mogillc/nico/README.md

# nico
The nico hexapod hardware and software files.

http://svn.mogi.io:8080/api/api/

To purchase 3D printed models please visit our shapeways store:
https://www.shapeways.com/shops/mogi
