mogillc/nico/edisonLibmogiPackage/examples/openGL/Objects/brickWall/diffuse.png

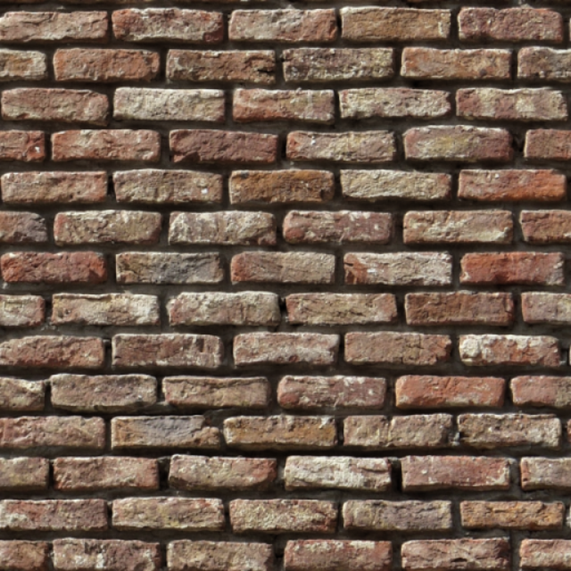
edisonLibmogiPackage/examples/openGL/Objects/brickWall/diffuse.png
