mogillc/nico/edisonLibmogiPackage/examples/openGL/Objects/brickWall/displacement.png

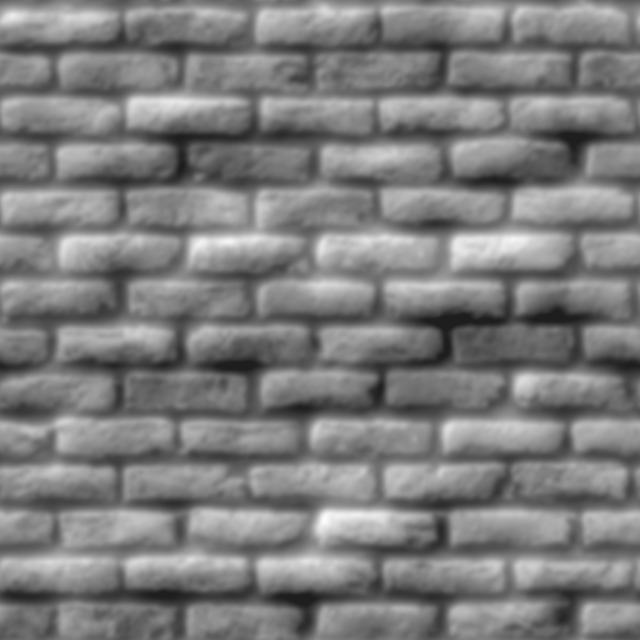
edisonLibmogiPackage/examples/openGL/Objects/brickWall/displacement.png
