mogillc/nico/edisonLibmogiPackage/examples/openGL/Objects/brickWall/normals.png

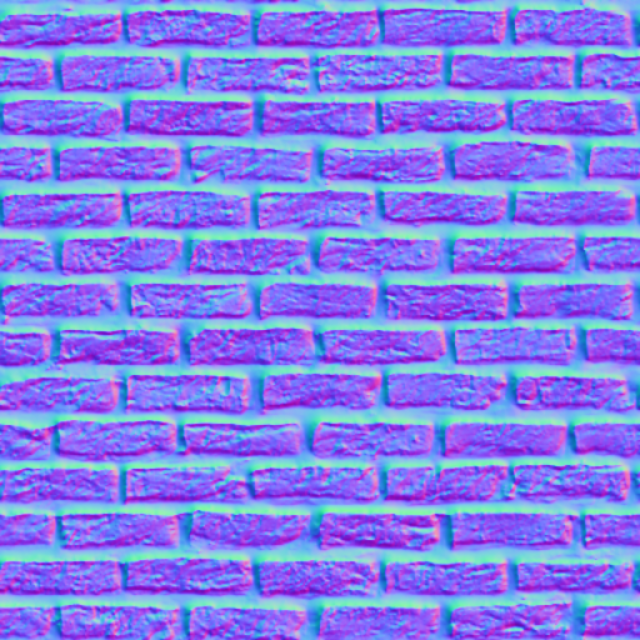
edisonLibmogiPackage/examples/openGL/Objects/brickWall/normals.png
