mogillc/nico/edisonLibmogiPackage/examples/openGL/Objects/brickWall/occlusion.png

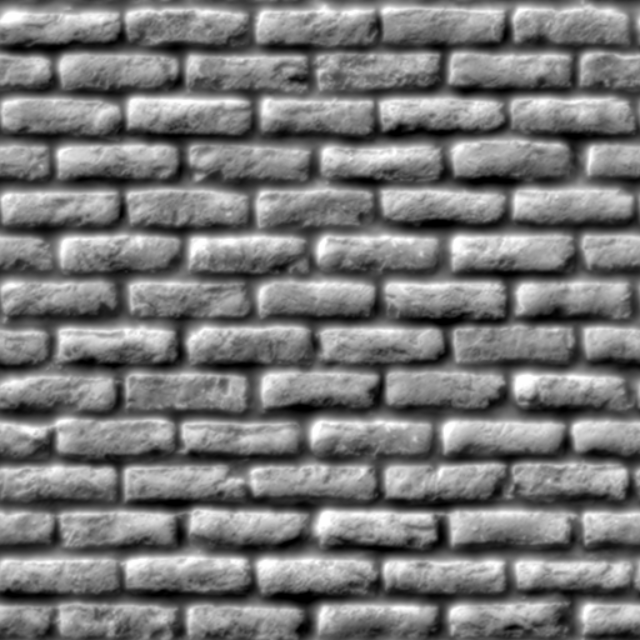
edisonLibmogiPackage/examples/openGL/Objects/brickWall/occlusion.png
