mogillc/nico/edisonLibmogiPackage/examples/openGL/Objects/brickWall/specularity.png

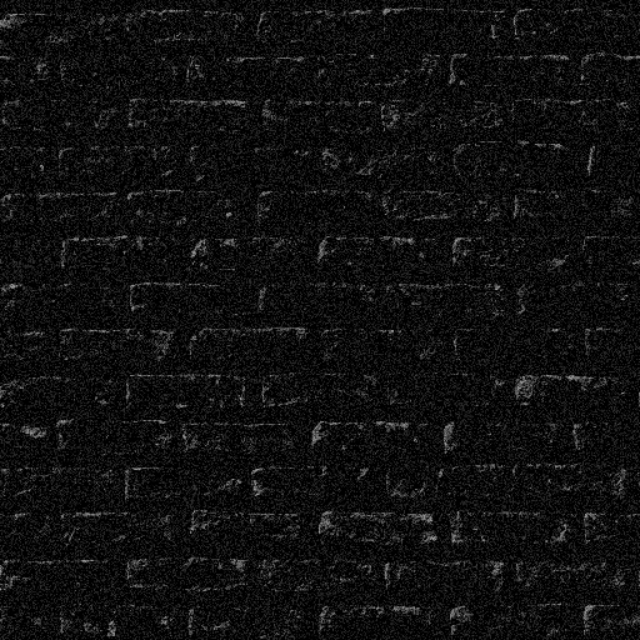
edisonLibmogiPackage/examples/openGL/Objects/brickWall/specularity.png
