mogillc/nico/edisonLibmogiPackage/examples/openGL/Objects/diffuse.png

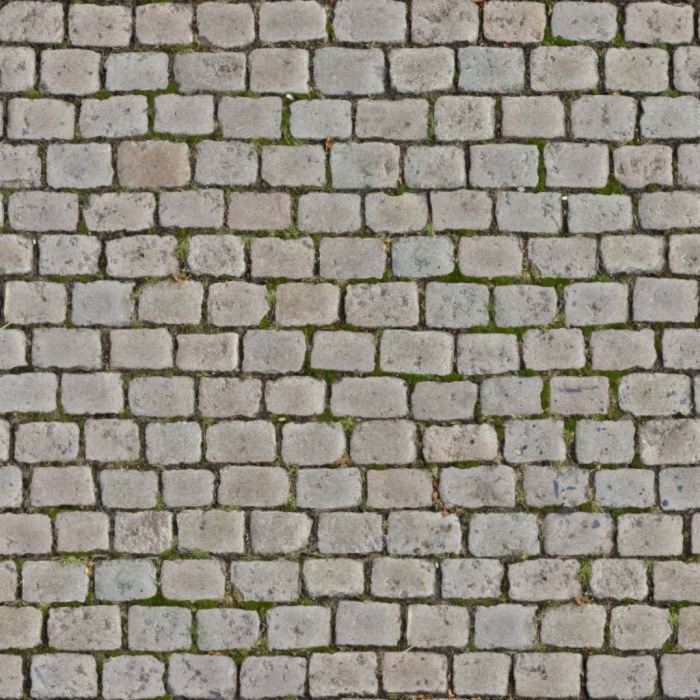
edisonLibmogiPackage/examples/openGL/Objects/diffuse.png
