mogillc/nico/edisonLibmogiPackage/examples/openGL/Objects/displacement.png

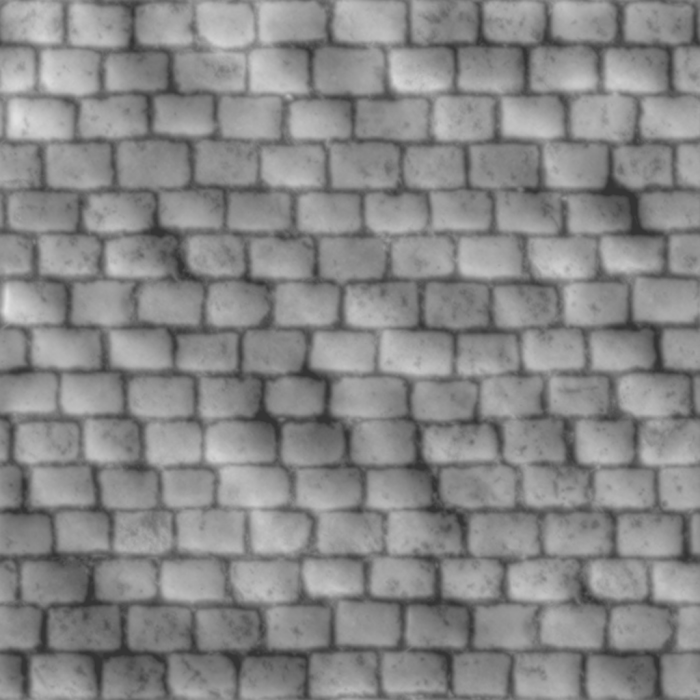
edisonLibmogiPackage/examples/openGL/Objects/displacement.png
