mogillc/nico/edisonLibmogiPackage/examples/openGL/Objects/normals.png

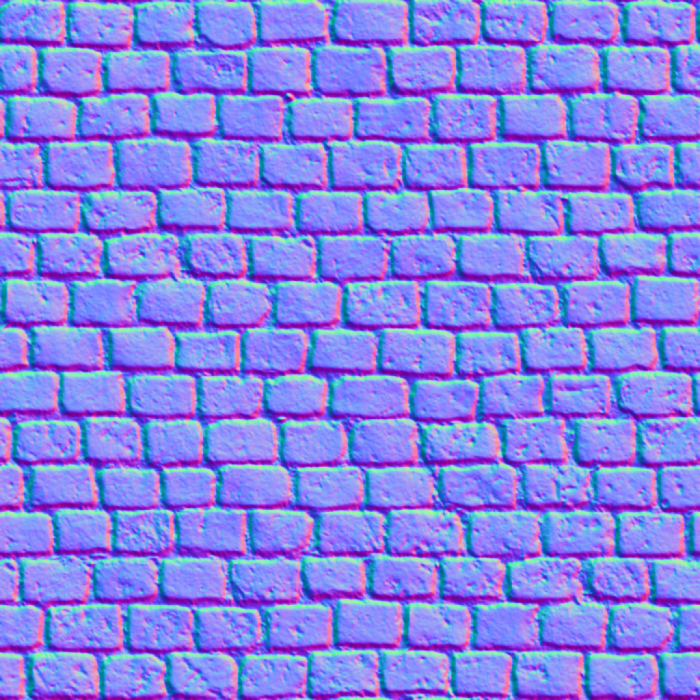
edisonLibmogiPackage/examples/openGL/Objects/normals.png
