mogillc/nico/edisonLibmogiPackage/examples/openGL/Objects/occlusion.png

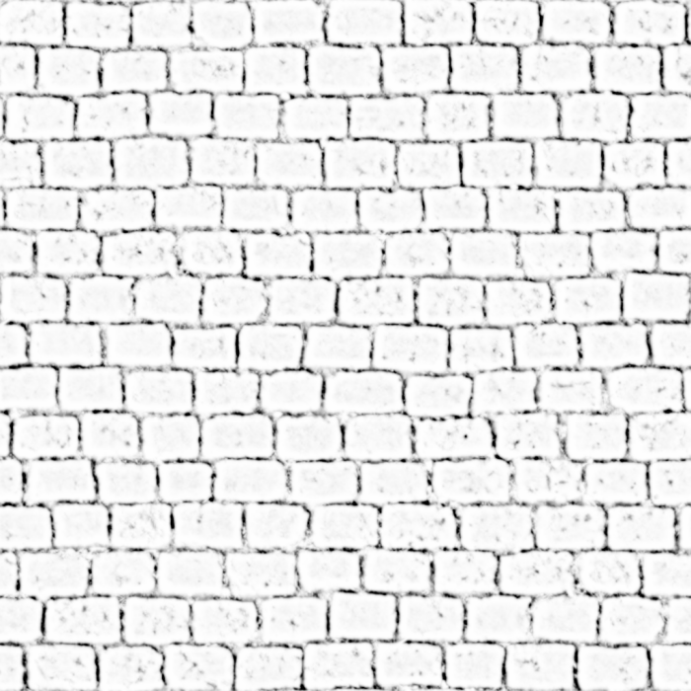
edisonLibmogiPackage/examples/openGL/Objects/occlusion.png
