mogillc/nico/edisonLibmogiPackage/examples/openGL/Objects/specularity.png

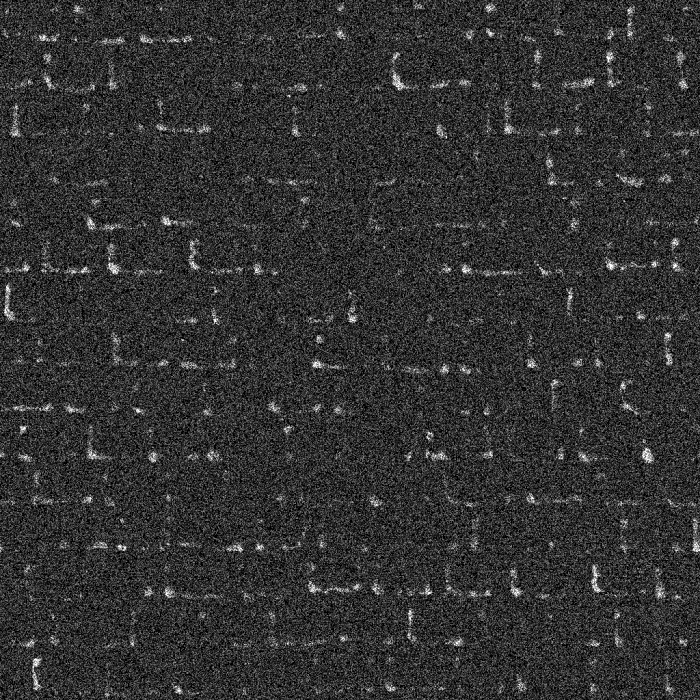
edisonLibmogiPackage/examples/openGL/Objects/specularity.png
