mogillc/nico/edisonLibmogiPackage/examples/openGL/Pics/brickWall/normals.png

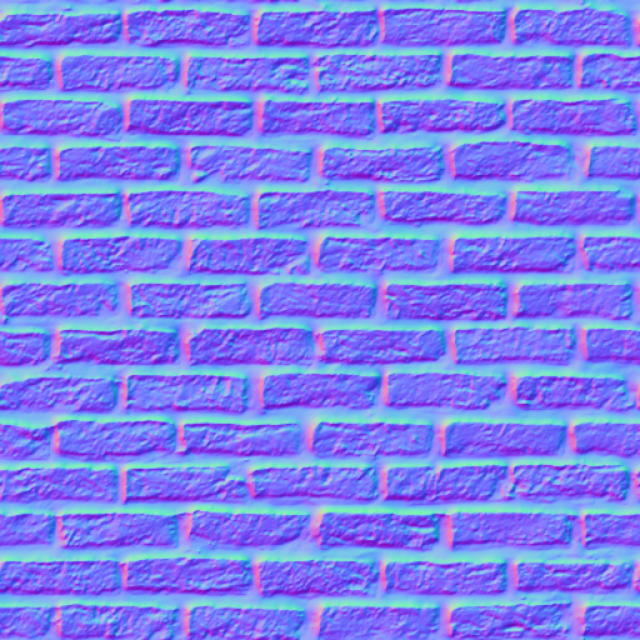
edisonLibmogiPackage/examples/openGL/Pics/brickWall/normals.png
