mogillc/nico/edisonLibmogiPackage/examples/openGL/Pics/Default-568h.png

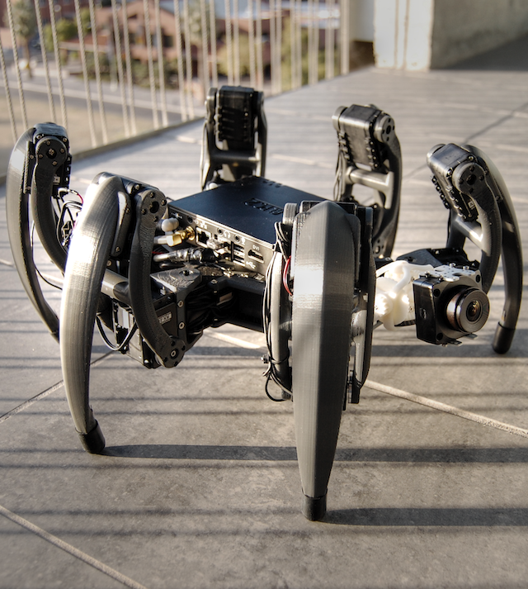
edisonLibmogiPackage/examples/openGL/Pics/Default-568h.png
