mogillc/nico/edisonLibmogiPackage/examples/openGL/Pics/paverStones/normals.png

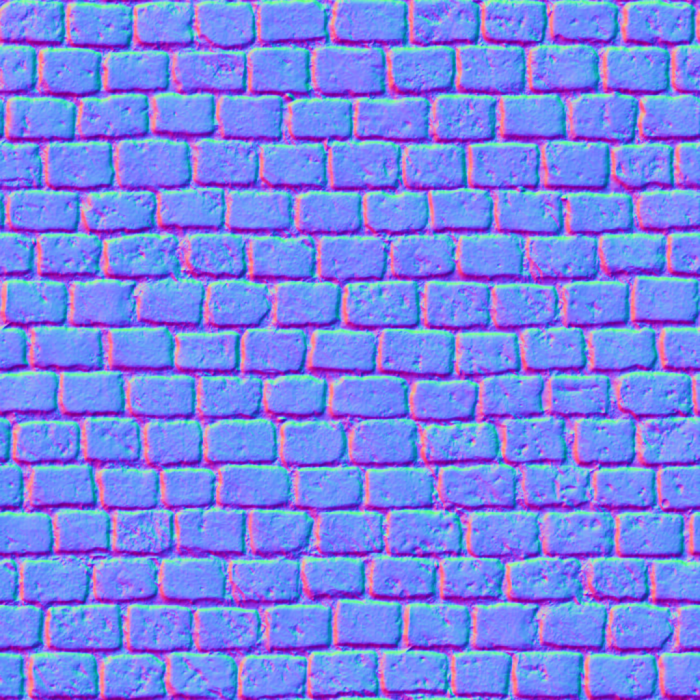
edisonLibmogiPackage/examples/openGL/Pics/paverStones/normals.png
