mogillc/nico/edisonLibmogiPackage/examples/openGL/Pics/paverStones/specularity.png

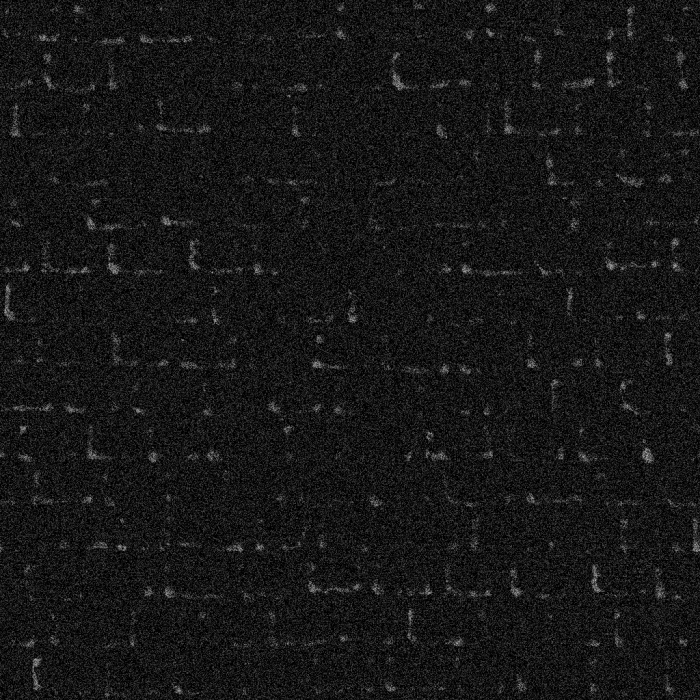
edisonLibmogiPackage/examples/openGL/Pics/paverStones/specularity.png
