mogillc/nico/edisonLibmogiPackage/examples/openGL/Pics/road1/diffuse.png

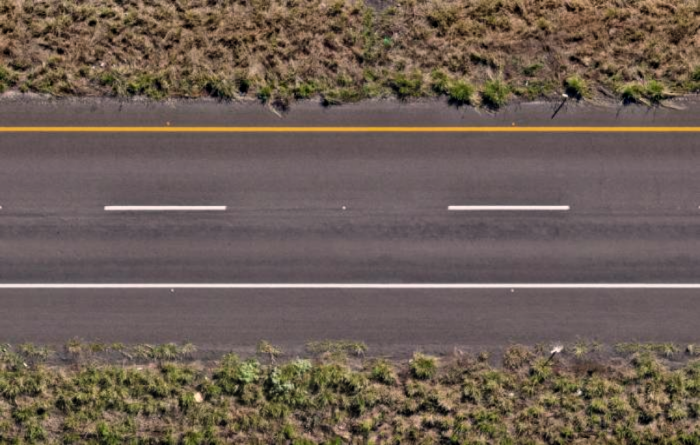
edisonLibmogiPackage/examples/openGL/Pics/road1/diffuse.png
