mogillc/nico/edisonLibmogiPackage/examples/openGL/Pics/road1/displacement.png

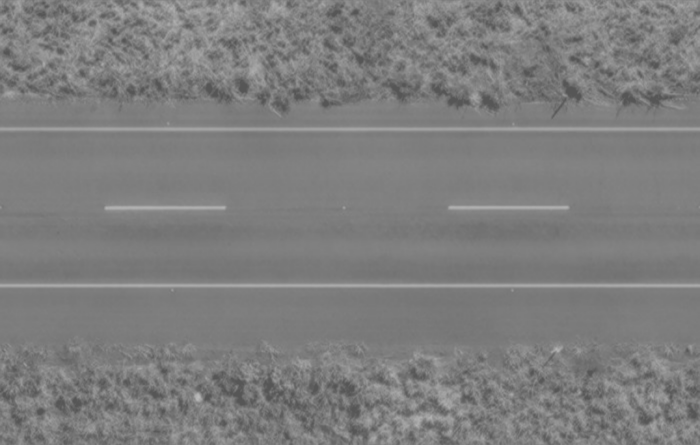
edisonLibmogiPackage/examples/openGL/Pics/road1/displacement.png
