mogillc/nico/edisonLibmogiPackage/examples/openGL/Pics/road1/normals.png

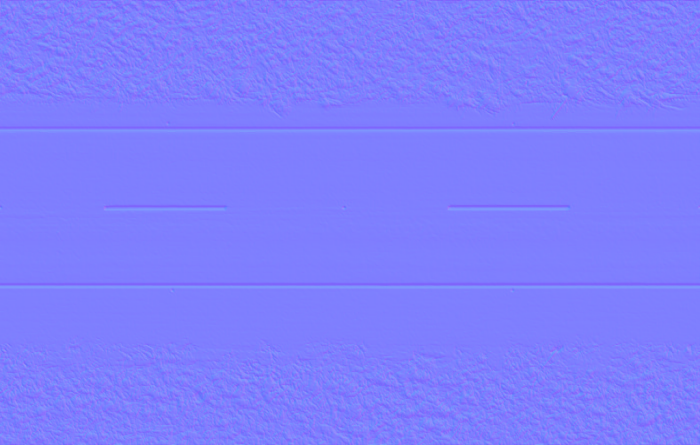
edisonLibmogiPackage/examples/openGL/Pics/road1/normals.png
