mogillc/nico/edisonLibmogiPackage/examples/openGL/Pics/road1/occlusion.png

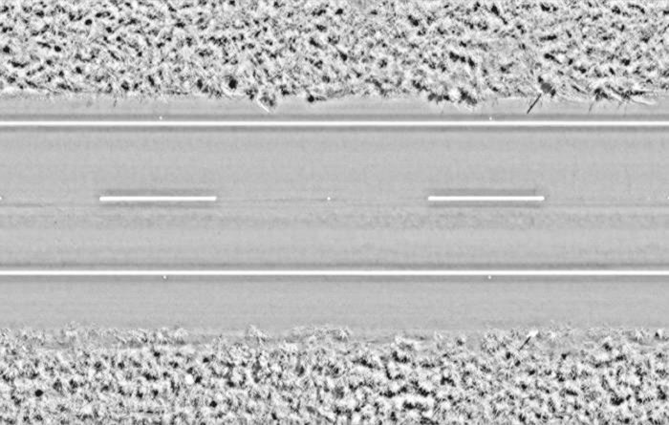
edisonLibmogiPackage/examples/openGL/Pics/road1/occlusion.png
