mogillc/nico/edisonLibmogiPackage/examples/openGL/Pics/road1/specularity.png

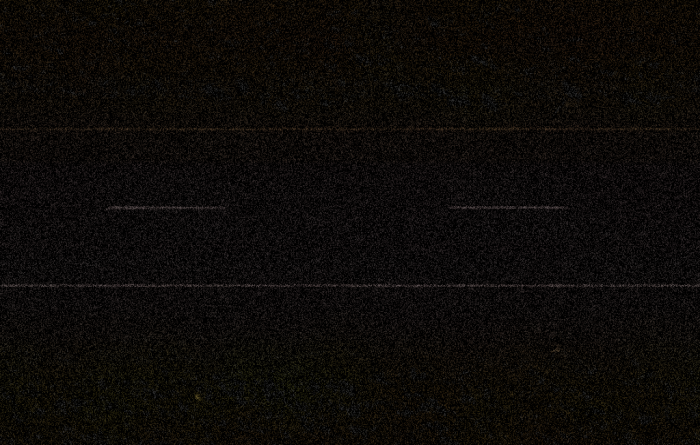
edisonLibmogiPackage/examples/openGL/Pics/road1/specularity.png
