mogillc/nico/edisonLibmogiPackage/examples/openGL/Pics/road2/diffuse.png

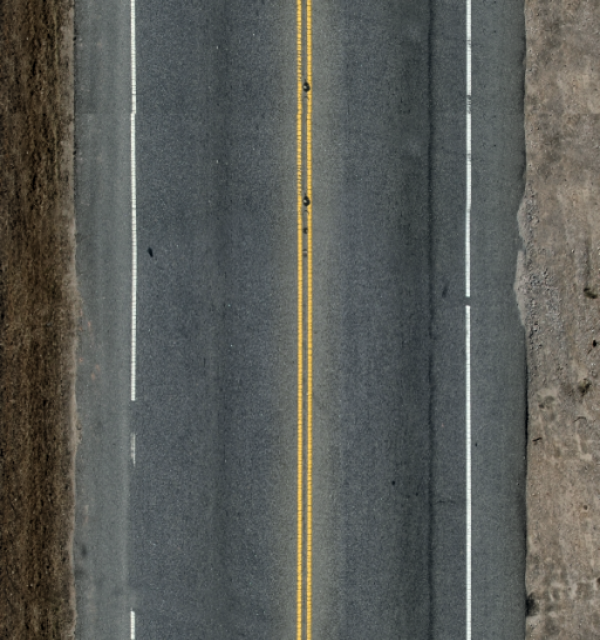
edisonLibmogiPackage/examples/openGL/Pics/road2/diffuse.png
