mogillc/nico/edisonLibmogiPackage/examples/openGL/Pics/road2/displacement.png

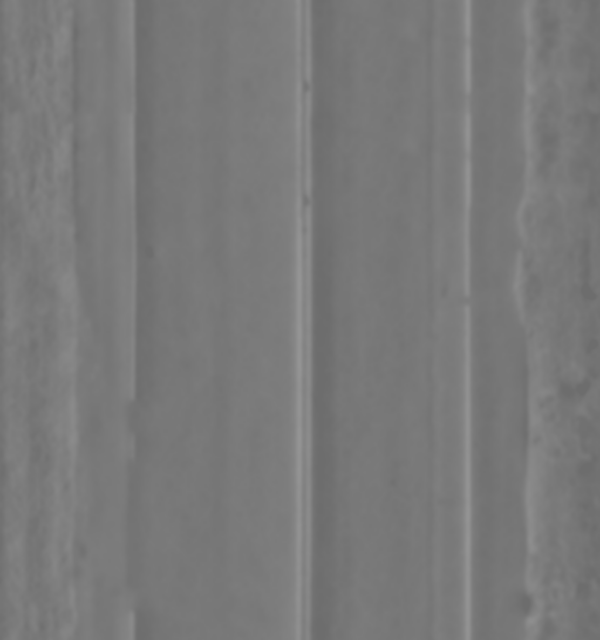
edisonLibmogiPackage/examples/openGL/Pics/road2/displacement.png
