mogillc/nico/edisonLibmogiPackage/examples/openGL/Pics/road2/normals.png

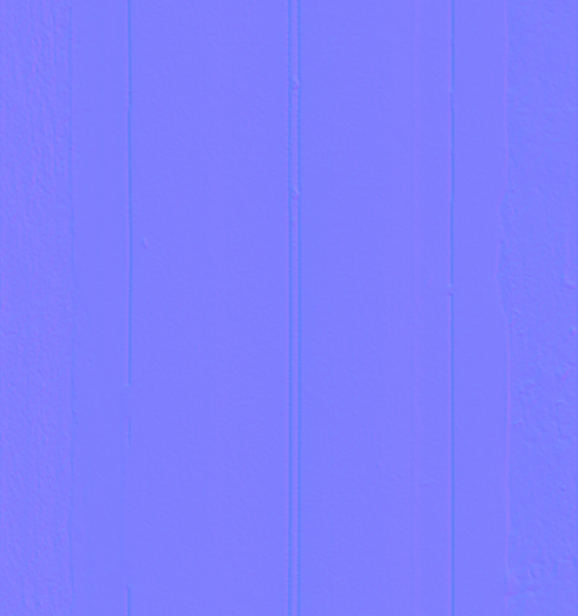
edisonLibmogiPackage/examples/openGL/Pics/road2/normals.png
