mogillc/nico/edisonLibmogiPackage/examples/openGL/Pics/road2/occlusion.png

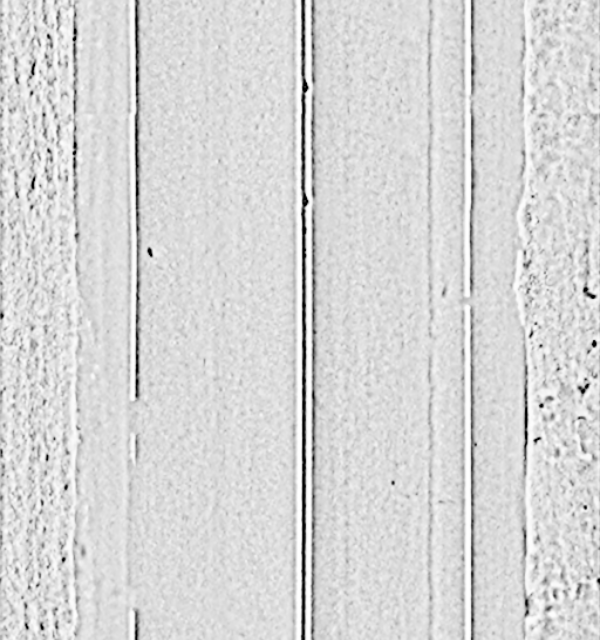
edisonLibmogiPackage/examples/openGL/Pics/road2/occlusion.png
