mogillc/nico/edisonLibmogiPackage/examples/openGL/Pics/road2/specularity.png

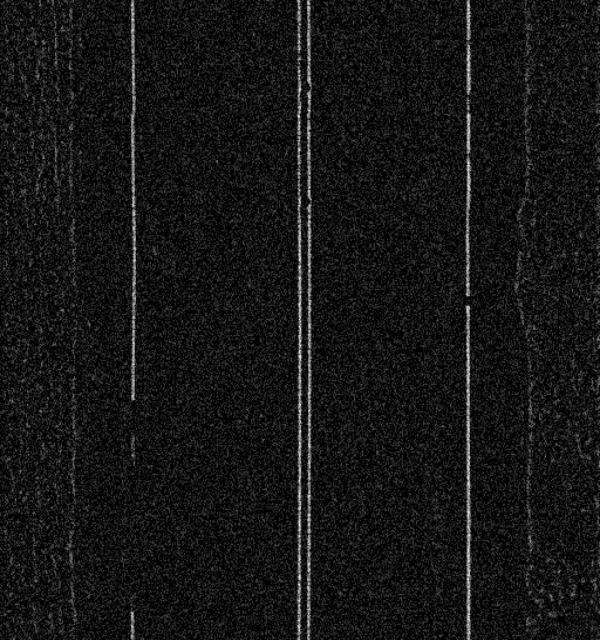
edisonLibmogiPackage/examples/openGL/Pics/road2/specularity.png
