mogillc/nico/edisonLibmogiPackage/examples/openGL/shaderTesting/testTexture/specularity.png

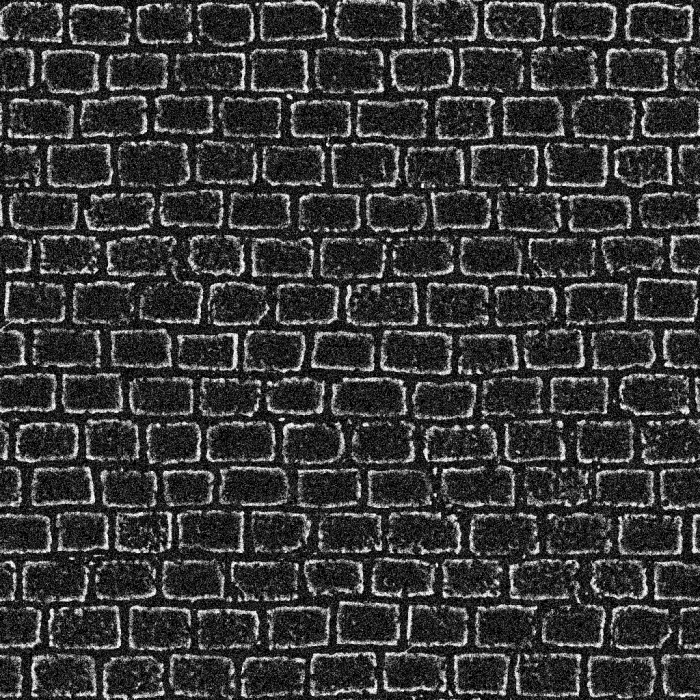
edisonLibmogiPackage/examples/openGL/shaderTesting/testTexture/specularity.png
