mogillc/nico/edisonLibmogiPackage/libmogi/doc/images/app.png

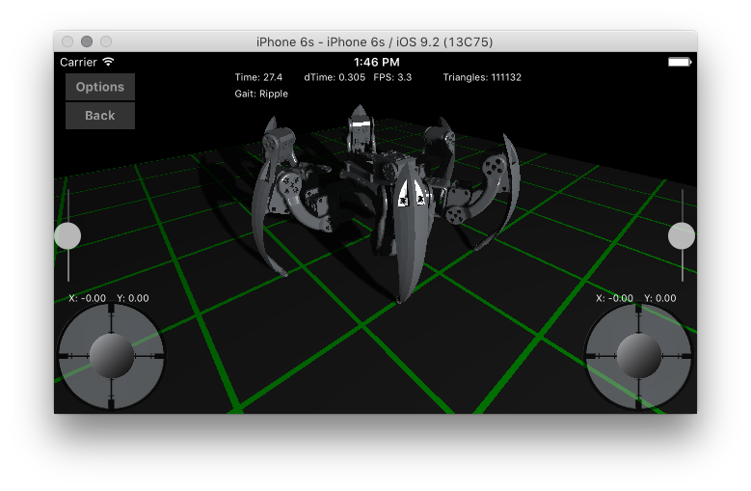
edisonLibmogiPackage/libmogi/doc/images/app.png
