mogillc/nico/edisonLibmogiPackage/libmogi/doc/images/appOptions.png

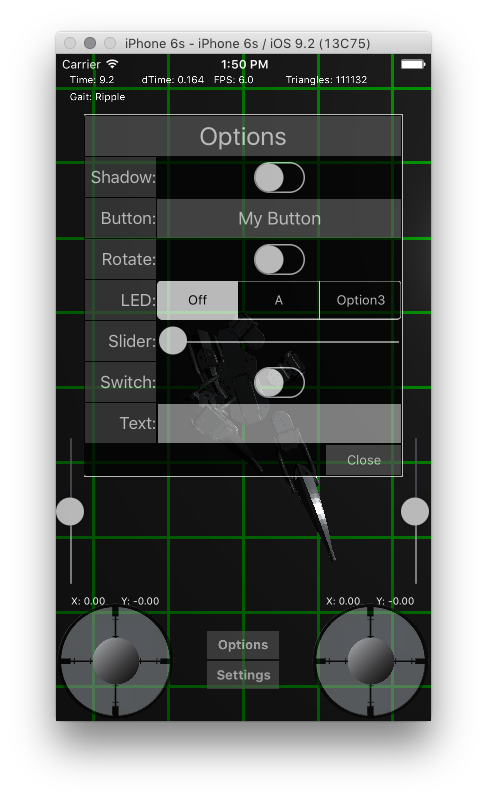
edisonLibmogiPackage/libmogi/doc/images/appOptions.png
