mogillc/nico/edisonLibmogiPackage/libmogi/doc/images/balanceGestures.jpg

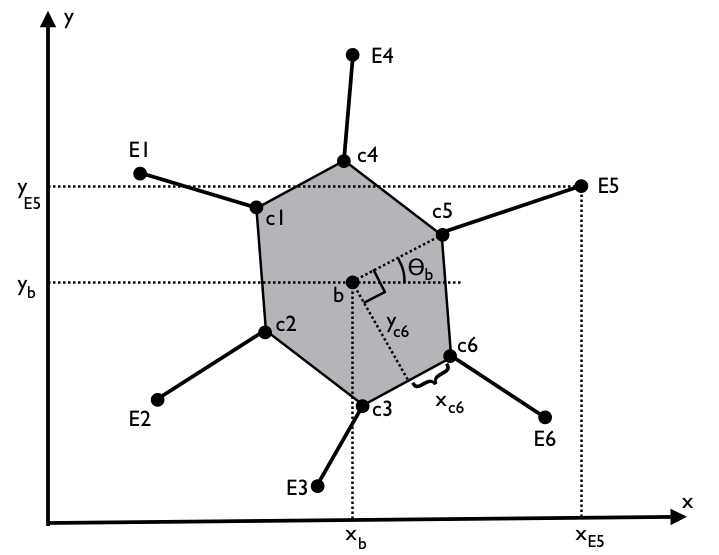
edisonLibmogiPackage/libmogi/doc/images/balanceGestures.jpg
