mogillc/nico/edisonLibmogiPackage/libmogi/doc/images/footTrajectory.jpg

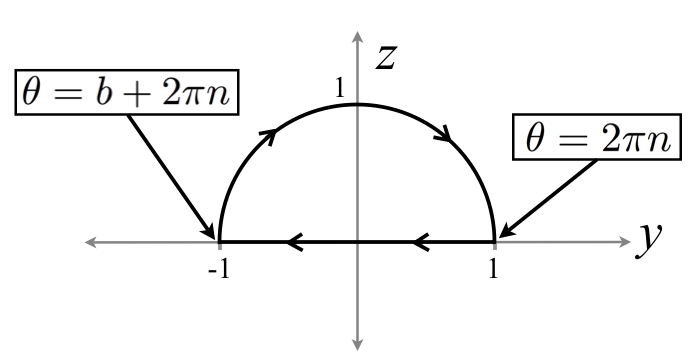
edisonLibmogiPackage/libmogi/doc/images/footTrajectory.jpg
