mogillc/nico/edisonLibmogiPackage/libmogi/doc/images/gaitSequences.jpg

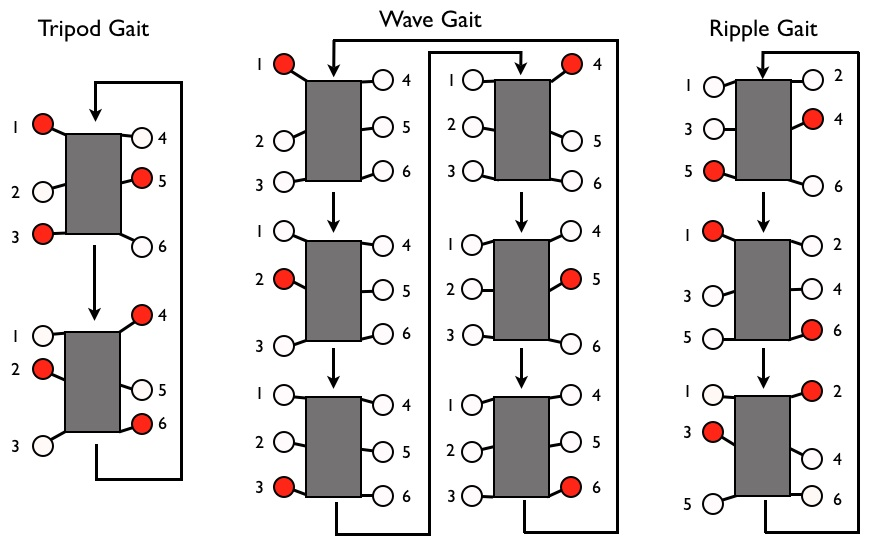
edisonLibmogiPackage/libmogi/doc/images/gaitSequences.jpg
