mogillc/nico/edisonLibmogiPackage/libmogi/doc/images/HexapodState.png

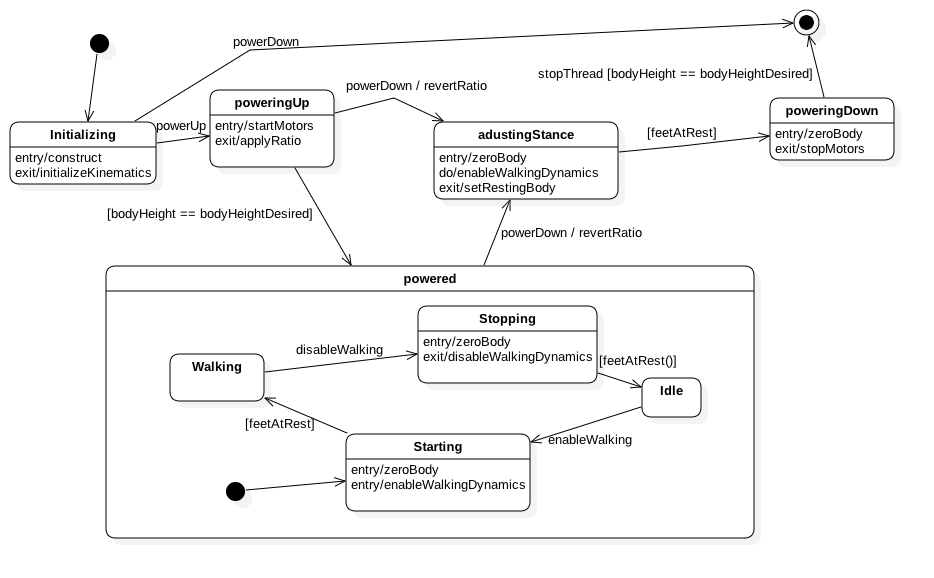
edisonLibmogiPackage/libmogi/doc/images/HexapodState.png
