mogillc/nico/edisonLibmogiPackage/libmogi/doc/images/legKinematics.jpg

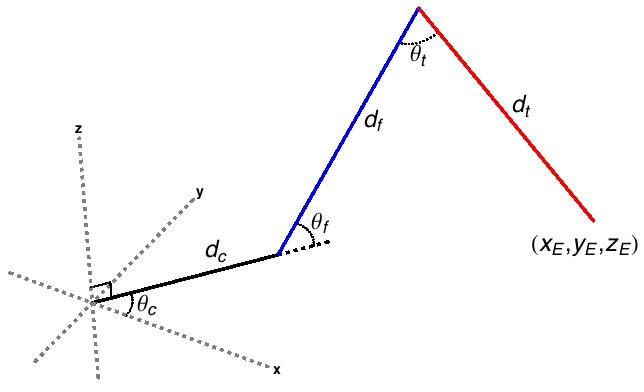
edisonLibmogiPackage/libmogi/doc/images/legKinematics.jpg
