mogillc/nico/edisonLibmogiPackage/libmogi/doc/images/walkingDynamics.jpg

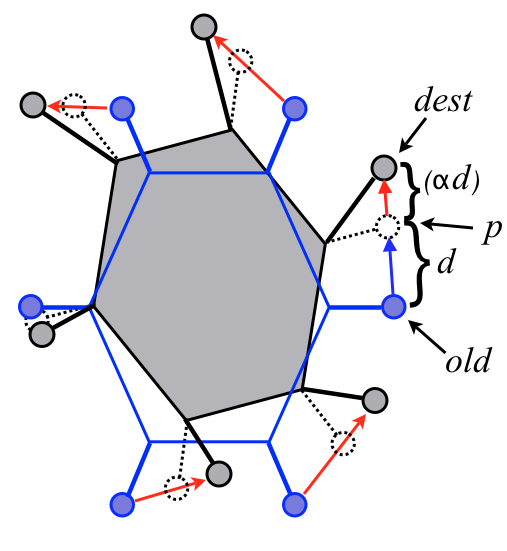
edisonLibmogiPackage/libmogi/doc/images/walkingDynamics.jpg
