mogillc/nico/hardware/pcb/xbee/schematic.png

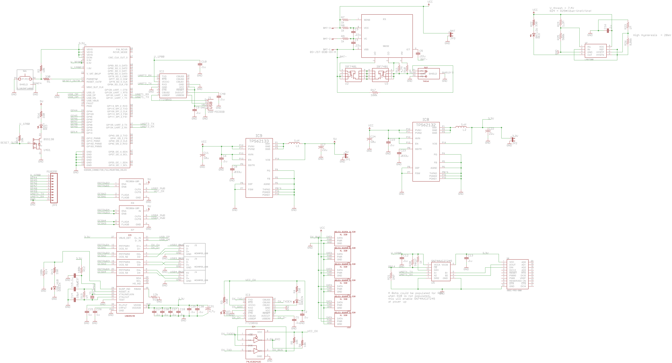
hardware/pcb/xbee/schematic.png
