mogillc/nico/hardware/pcb/BOM.xlsx

 |  |  | Nico BOM
 |  |  |  | Number of hexapods: | 3
description |  | search term/model | Link | Board ID | Qty per hex | Qty total
CAP CER 0.1UF 10V 10% X5R 0402 | LMK105BJ104KV-F | 587-1227-1-ND | http://www.digikey.com/product-detail/en/LMK105BJ104KV-F/587-1227-1-ND/931004 | C1, C2, C6, C9, C10, C17, C18, C19, C20, C25, C27, C37, C38, C48 | 14 | 42
CAP CER 0.033UF 10V 10% X5R 0402 | GRM155R61A333KA01D | 490-5411-1-ND | http://www.digikey.com/product-detail/en/GRM155R61A333KA01D/490-5411-1-ND/2175218 | C8, C23 | 2 | 6
CAP CER 0.22UF 16V 10% X5R 0402 | EMK105BJ224KV-F | 587-1452-1-ND | http://www.digikey.com/product-detail/en/EMK105BJ224KV-F/587-1452-1-ND/1004083 | C3, C4, C5 | 3 | 9
CAP CER 22UF 10V 20% X5R 0603 | C1608X5R1A226M080AC | 445-9077-1-ND | http://www.digikey.com/product-detail/en/C1608X5R1A226M080AC/445-9077-1-ND/3661620 | C7, C22 | 2 | 6
CAP CER 1UF 6.3V 10% X5R 0402 | GRM155R60J105KE19D | 490-1320-1-ND | http://www.digikey.com/product-detail/en/GRM155R60J105KE19D/490-1320-1-ND/587919 | C21, C26 | 2 | 6
CAP CER 10UF 16V 10% X5R 0805 | GRM21BR61C106KE15L | 490-3886-1-ND | http://www.digikey.com/product-detail/en/GRM21BR61C106KE15L/490-3886-1-ND/965928 | C11, C24 | 2 | 6
CAP CER 4.7UF 6.3V 20% X5R 0603 | GRM188R60J475ME19D | 490-5421-1-ND | http://www.digikey.com/product-detail/en/GRM188R60J475ME19D/490-5421-1-ND/2175228 | C31 | 1 | 3
CAP CER 18PF 50V 5% NP0 0402 | CL05C180JB5NNNC | 1276-1140-1-ND | http://www.digikey.com/product-detail/en/CL05C180JB5NNNC/1276-1140-1-ND/3889226 | C14, C15 | 2 | 6
LED RED ORANGE CLEAR 0603 SMD | LTST-C190EKT | 160-1182-1-ND | http://www.digikey.com/product-detail/en/LTST-C190EKT/160-1182-1-ND/269254 | DRX | 1 | 3
LED GREEN CLEAR 0603 SMD | LTST-C190GKT | 160-1183-1-ND | http://www.digikey.com/product-detail/en/LTST-C190GKT/160-1183-1-ND/269255 | DTX, USB_HUB, BOOT | 3 | 9
FIXED IND 1UH 3.1A 35 MOHM SMD | 252012CDMCDS-1R0MC | 308-2342-1-ND | http://www.digikey.com/product-detail/en/252012CDMCDS-1R0MC/308-2342-1-ND/4386567 | L1, L2 | 2 | 6
RES SMD 330 OHM 1% 1/10W 0402 | ERJ-2RKF3300X | P330LCT-ND | http://www.digikey.com/product-detail/en/ERJ-2RKF3300X/P330LCT-ND/1746671 | R1, R3, R4, R13, R16 | 5 | 15
RES SMD 10K OHM 1% 1/10W 0402 | ERJ-2RKF1002X | P10.0KLCT-ND | http://www.digikey.com/product-detail/en/ERJ-2RKF1002X/P10.0KLCT-ND/194119 | R2, R5, R6, R15 | 4 | 12
RES SMD 1K OHM 1% 1/10W 0402 | ERJ-2RKF1001X | P1.00KLCT-ND | http://www.digikey.com/product-detail/en/ERJ-2RKF1001X/P1.00KLCT-ND/97341 | R7, R8, R9, R10 | 4 | 12
RES SMD 4.7M OHM 1% 1/16W 0402 | CRCW04024M70FKED | 541-4.70MLCT-ND | http://www.digikey.com/product-detail/en/CRCW04024M70FKED/541-4.70MLCT-ND/1183541 | R11 | 1 | 3
RES SMD 1M OHM 1% 1/10W 0402 | ERJ-2RKF1004X | P1.00MLCT-ND | http://www.digikey.com/product-detail/en/ERJ-2RKF1004X/P1.00MLCT-ND/79804 | R19 | 1 | 3
RES SMD 12K OHM 1% 1/10W 0402 | ERJ-2RKF1202X | P12.0KLCT-ND | http://www.digikey.com/product-detail/en/ERJ-2RKF1202X/P12.0KLCT-ND/1746638 | R18 | 1 | 3
RES SMD 100K OHM 1% 1/10W 0402 | ERJ-2RKF1003X | P100KLCT-ND | http://www.digikey.com/product-detail/en/ERJ-2RKF1003X/P100KLCT-ND/194127 | R12, R14, R17 | 3 | 9
CRYSTAL 24.0MHZ 18PF SMD | 405I35D24M00000 | CTX1198CT-ND | http://www.digikey.com/product-detail/en/405I35D24M00000/CTX1198CT-ND/4308775 | Y1 | 1 | 3
CONN RCPT 0.4MM SMD 70POS SHLD (for edison, 3mm) | DF40GB(3.0)-70DS-0.4V(51) | DF40GB(3.0)-70DS-0.4V(51)-ND | http://www.digikey.com/product-search/en?pv1263=58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 | U1 | 1 | 3
MOSFET N-CH 20V 8.7A 8-SOIC | IRF7401TRPBF | IRF7401PBFCT-ND | http://www.digikey.com/product-detail/en/IRF7401TRPBF/IRF7401PBFCT-ND/812582 | U2, U3 | 2 | 6
MOSFET 2N-CH 50V 200MA SC70-6 | BSS138DW-7-F | BSS138DW-FDICT-ND | http://www.digikey.com/product-detail/en/BSS138DW-7-F/BSS138DW-FDICT-ND/808541 | U4 | 1 | 3
IC BATT PROTECTION 2CELL 8-TSSOP | S-8232ABFT-T2-G | 728-1031-1-ND | http://www.digikey.com/product-detail/en/S-8232ABFT-T2-G/728-1031-1-ND/1628434 | IC1 | 1 | 3
FT230XQ-R | FT230XQ-R | 768-1130-1-ND | http://www.digikey.com/product-detail/en/FT230XQ-R/768-1130-1-ND/3029158 | IC2, IC3 | 2 | 6
IC BUFFER/DVR 3ST DL INV 8VSSOP | 74LVC2G241DC,125 | 568-9344-1-ND | http://www.digikey.com/product-detail/en/74LVC2G241DC,125/568-9344-1-ND/2814262 | IC4 | 1 | 3
IC USB 2.0 4PORT HUB CTLR 36QFN | USB2514B-AEZC | 638-1122-ND | http://www.digikey.com/product-detail/en/USB2514B-AEZC/638-1122-ND/3056579 | IC5 | 1 | 3
IC DISTRIBUTION SW DUAL 8-SOIC | MIC2026-1YM | 576-2137-ND | http://www.digikey.com/product-detail/en/MIC2026-1YM/576-2137-ND/1027887 | IC6, IC7 | 2 | 6
IC REG BUCK SYNC 3.3V 3A 16QFN | TPS62132RGTR | 296-29936-1-ND | http://www.digikey.com/product-detail/en/TPS62132RGTR/296-29936-1-ND/2786735 | IC8 | 1 | 3
IC REG BUCK SYNC 5V 3A 16QFN | TPS62133RGTR | 296-29937-1-ND | http://www.digikey.com/product-detail/en/TPS62133RGTR/296-29937-1-ND/2786736 | IC9 | 1 | 3
SWITCH TACTILE SPST-NO 0.05A 12V | TL1015AF160QG | EG4344CT-ND | http://www.digikey.com/product-detail/en/TL1015AF160QG/EG4344CT-ND/1003792 | SW1 | 1 | 3
SWITCH TOGGLE SPDT 0.4VA 20V | ET01MD1ABE | CKN1073-ND | http://www.digikey.com/product-search/en?KeyWords=ET01MD1ABE%20&WT.z_header=search_go | SW2 | 1 | 3
SIL VERTICAL PC TAIL PIN HEADER | M20-9990245 | 952-2261-ND | http://www.digikey.com/product-search/en?x=0&y=0&lang=en&site=us&keywords=952-2261-nd | JP1, JP2, JP3 | 3 | 9
DNP | DNP | DNP | DNP | JP4 | 0 | 0
CONN HEADER 3POS 2MM RT ANG TIN | 53254-0370 | WM19000-ND | http://www.digikey.com/product-detail/en/53254-0370/WM19000-ND/1952199 | J10, J11, J12, J13, J14, J15 | 6 | 18
CONN HEADER 4POS 2MM RT ANG TIN | 532540470 | WM19001-ND | http://www.digikey.com/product-detail/en/0532540470/WM19001-ND/1952200 | J2, J3, J4 | 3 | 9
CONN HEADER XH SIDE 3POS 2.5MM | S3B-XH-A(LF)(SN) | S3B-XH-A(LF)(SN) | http://www.digikey.com/product-search/en?pv88=5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 | BAT | 1 | 3
CONN RCPT STD MICRO USB TYPE B | 10104110-0001LF | 609-4052-1-ND | http://www.digikey.com/product-detail/en/10104110-0001LF/609-4052-1-ND/2350358 | J1 | 1 | 3
Not included in the list:
Edison standoffs for 3.0mm spacing. See part U1.
