mogillc/nico/edisonLibmogiPackage/examples/openGL/Objects/arm/segment5.STL

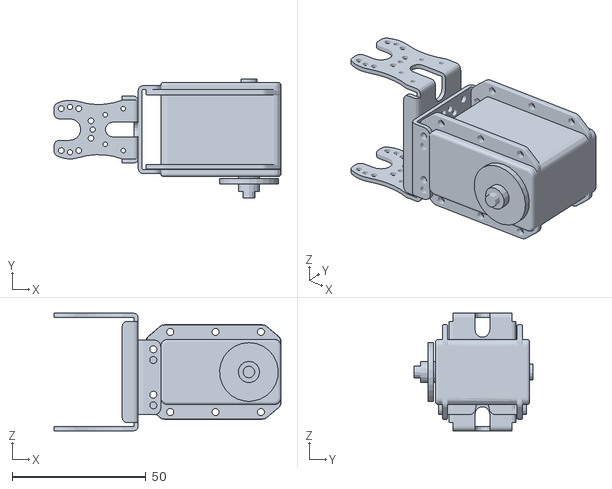
[picture p36: CAD file, 2016-02-10]
edisonLibmogiPackage/examples/openGL/Objects/arm/segment5.STL
85.0 x 44.5 x 44.0
