mogillc/nico/edisonLibmogiPackage/examples/openGL/Objects/brickWall/brickWall.obj

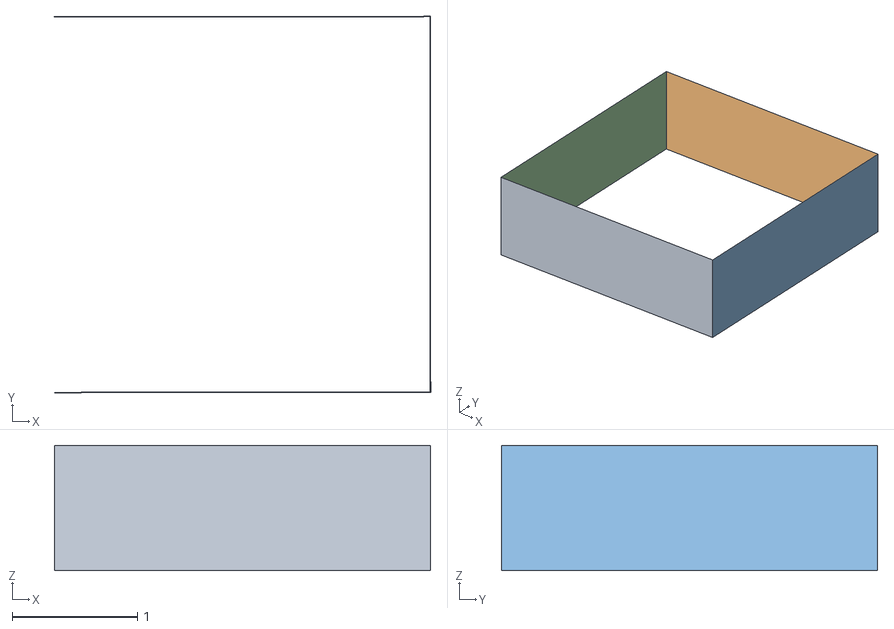
[picture p37: CAD file, 2016-02-10]
edisonLibmogiPackage/examples/openGL/Objects/brickWall/brickWall.obj
3.00 x 3.00 x 1.00
Plane.003
Plane.002
Plane.001
Plane
