mogillc/nico/edisonLibmogiPackage/examples/openGL/Objects/capsule/capsule.obj

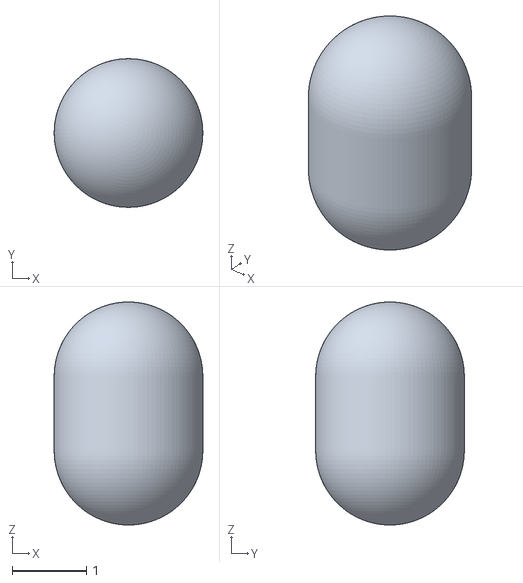
[picture p38: CAD file, 2016-02-10]
edisonLibmogiPackage/examples/openGL/Objects/capsule/capsule.obj
2.00 x 2.00 x 3.00
