mogillc/nico/edisonLibmogiPackage/examples/openGL/Objects/testCube.ply

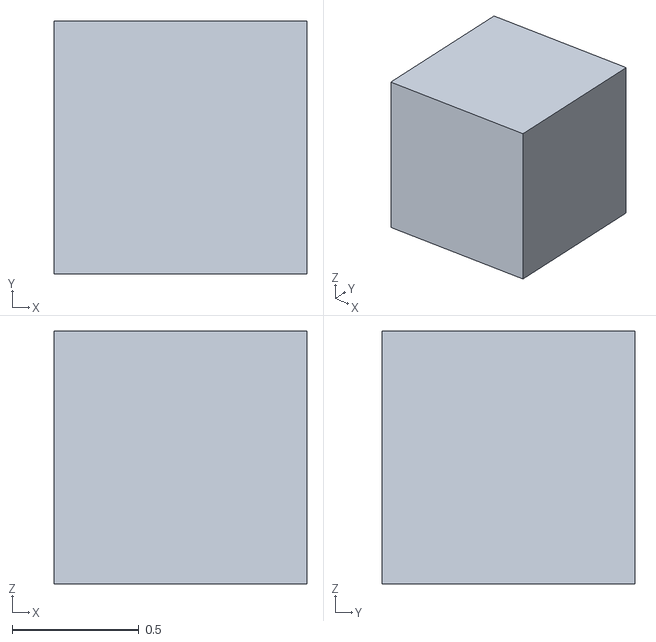
[picture p39: CAD file, 2016-03-11]
edisonLibmogiPackage/examples/openGL/Objects/testCube.ply
1.00 x 1.00 x 1.00
