mogillc/nico/edisonLibmogiPackage/examples/openGL/STL/Femur_rx28_opengl.STL

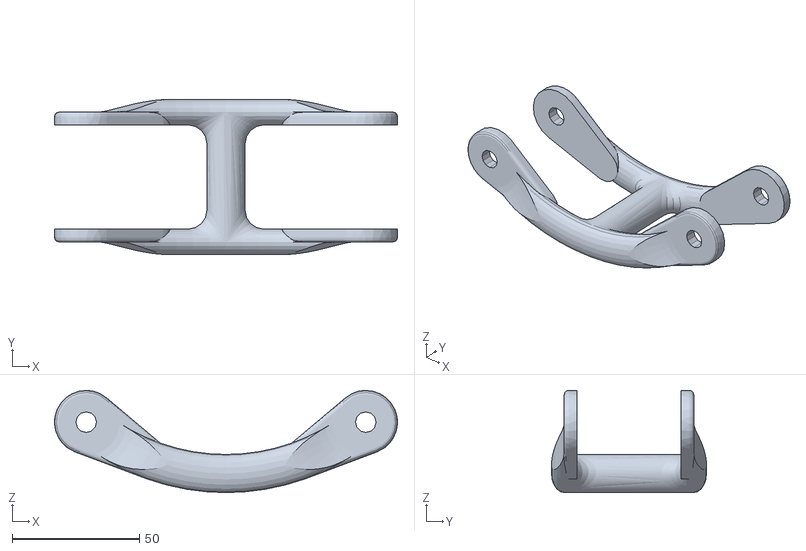
[picture p40: CAD file, 2016-02-10]
edisonLibmogiPackage/examples/openGL/STL/Femur_rx28_opengl.STL
135.0 x 61.0 x 40.2
