mogillc/nico/edisonLibmogiPackage/libmogi/simulation/resources/models/arm/segment4.STL

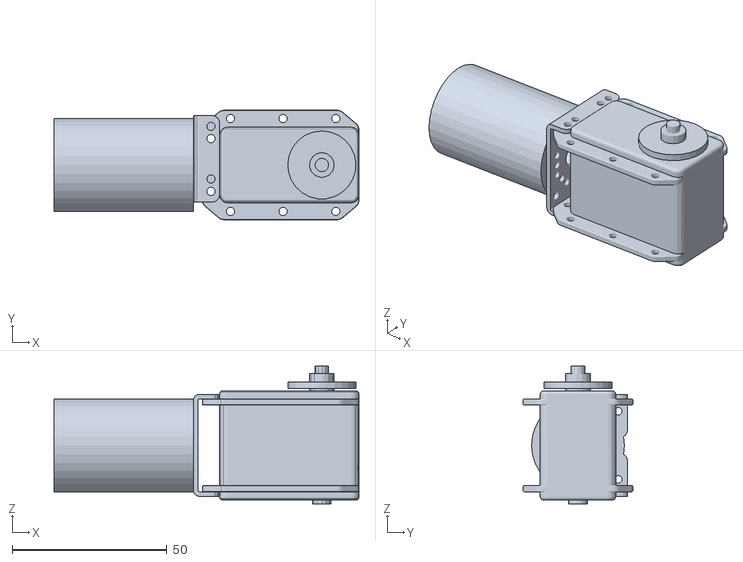
[picture p41: CAD file, 2016-02-10]
edisonLibmogiPackage/libmogi/simulation/resources/models/arm/segment4.STL
98.5 x 35.4 x 44.5
