mogillc/nico/edisonLibmogiPackage/libmogi/simulation/resources/models/dmitri/body.stl

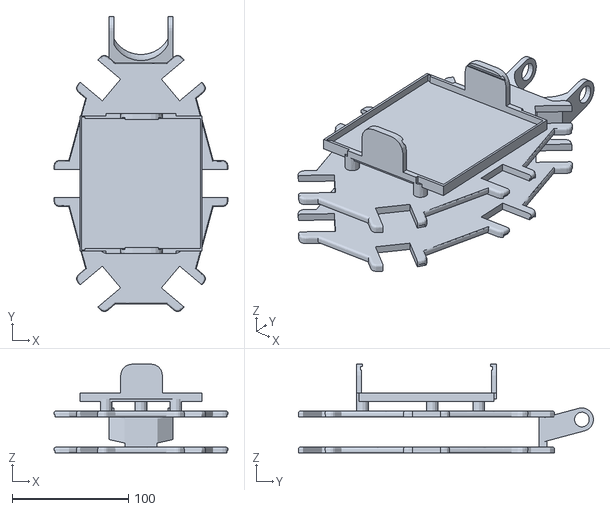
[picture p42: CAD file, 2016-02-10]
edisonLibmogiPackage/libmogi/simulation/resources/models/dmitri/body.stl
149.4 x 253.4 x 76.3
