mogillc/nico/edisonLibmogiPackage/libmogi/simulation/resources/models/dmitri/leg/coxa.stl

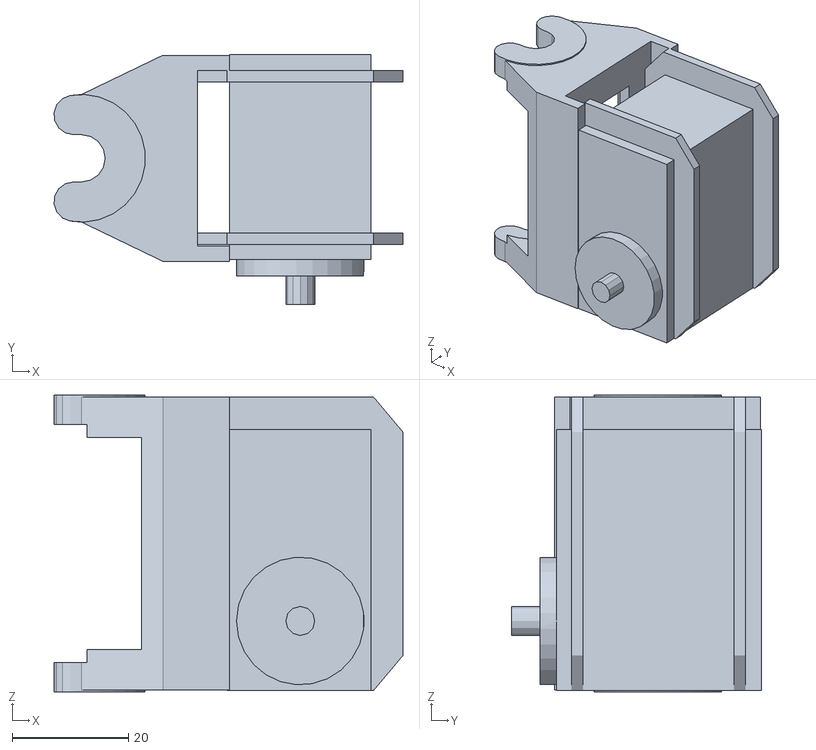
[picture p43: CAD file, 2016-02-10]
edisonLibmogiPackage/libmogi/simulation/resources/models/dmitri/leg/coxa.stl
60.1 x 43.0 x 51.1
