mogillc/nico/edisonLibmogiPackage/libmogi/simulation/resources/models/nico/body.stl

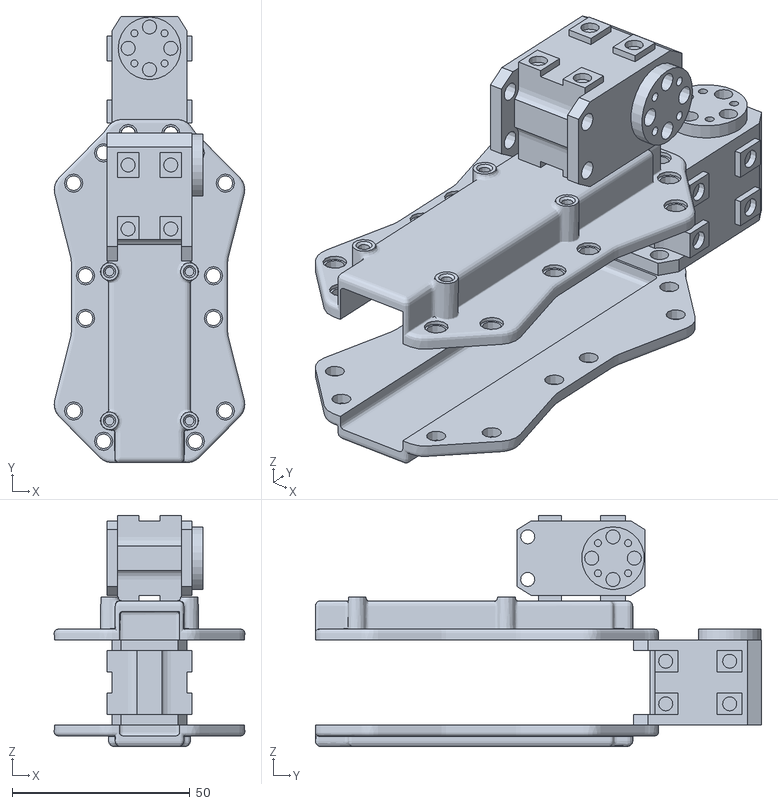
[picture p44: CAD file, 2016-02-10]
edisonLibmogiPackage/libmogi/simulation/resources/models/nico/body.stl
53.6 x 125.6 x 65.0
