mogillc/nico/edisonLibmogiPackage/libmogi/simulation/resources/models/nico/leg/tibia.stl

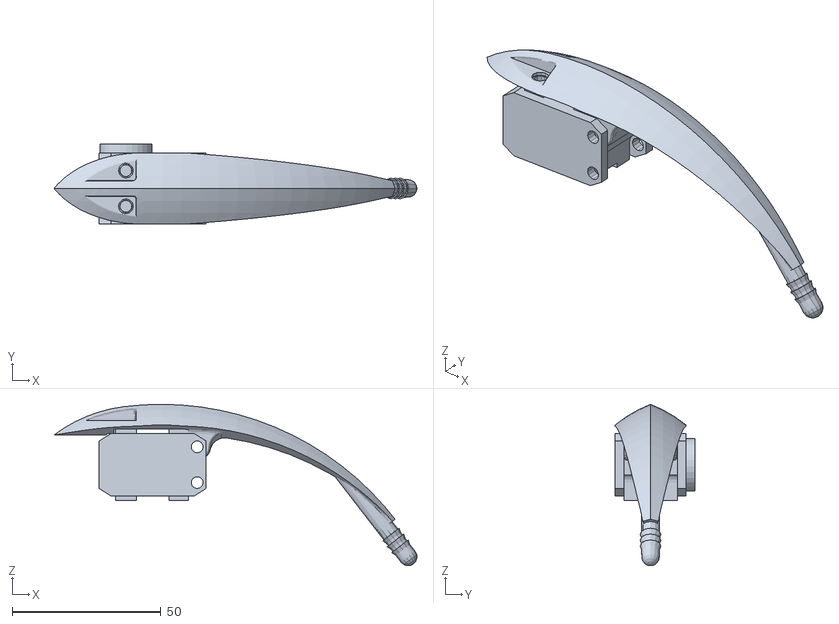
[picture p45: CAD file, 2016-02-10]
edisonLibmogiPackage/libmogi/simulation/resources/models/nico/leg/tibia.stl
122.2 x 27.0 x 54.3
