mogillc/nico/hardware/3D/tibiaLong_SLA.STL

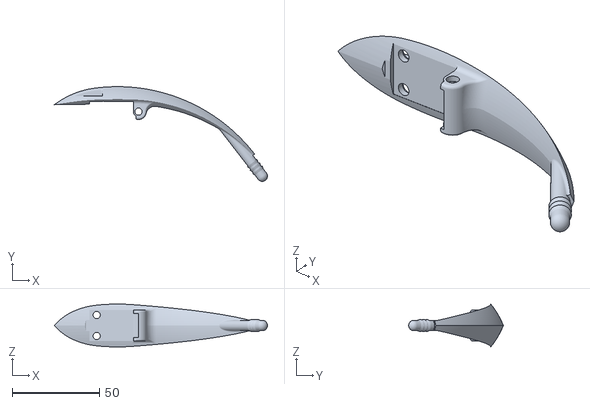
[picture p46: CAD file, 2016-10-25]
hardware/3D/tibiaLong_SLA.STL
122.2 x 54.3 x 24.6
