mogillc/nico/edisonLibmogiPackage/examples/openGL/Objects/paverStones.obj

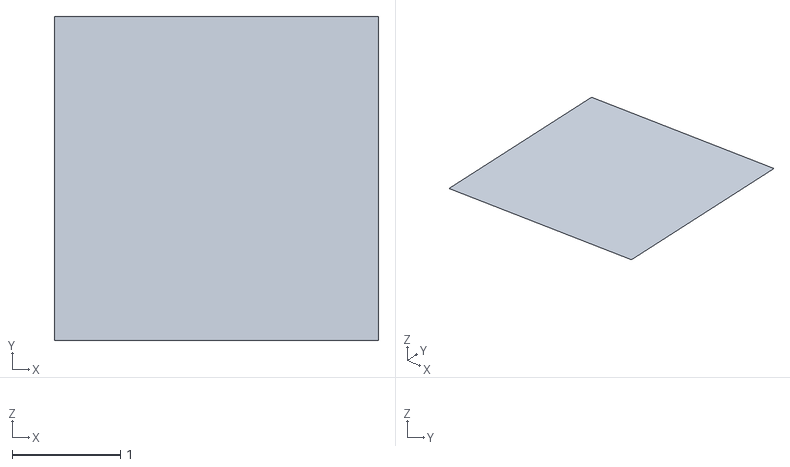
[picture p47: CAD file, 2016-02-10]
edisonLibmogiPackage/examples/openGL/Objects/paverStones.obj
3.00 x 3.00 x 0
