mogillc/nico/edisonLibmogiPackage/examples/openGL/STL/coxa_bracket_MX_28_opengl.STL

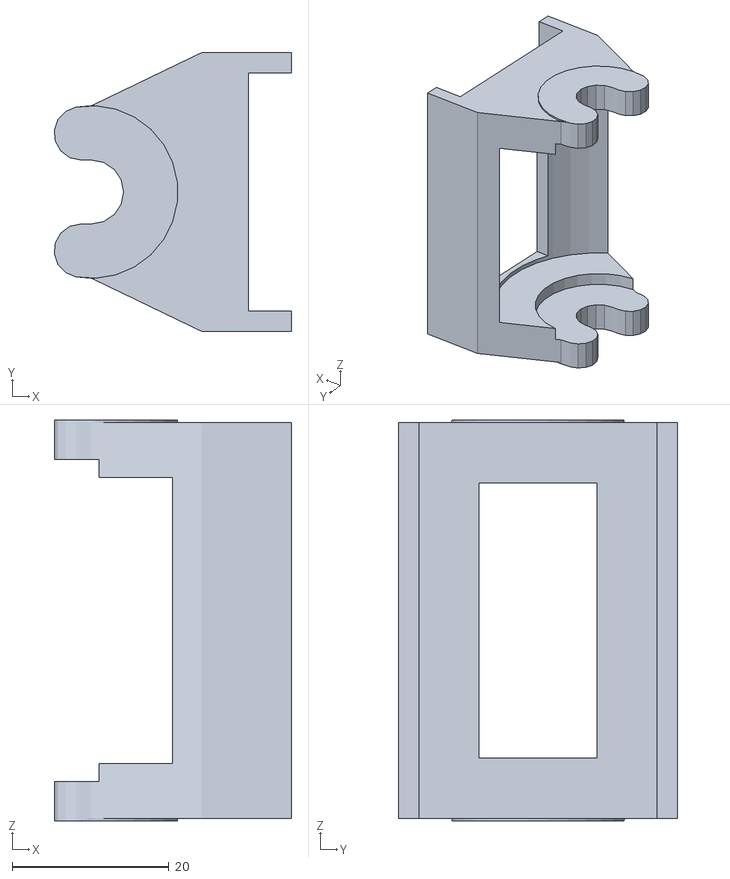
[picture p48: CAD file, 2016-02-10]
edisonLibmogiPackage/examples/openGL/STL/coxa_bracket_MX_28_opengl.STL
30.2 x 35.5 x 51.1
