mogillc/nico/edisonLibmogiPackage/libmogi/simulation/resources/models/arm/launchpad.STL

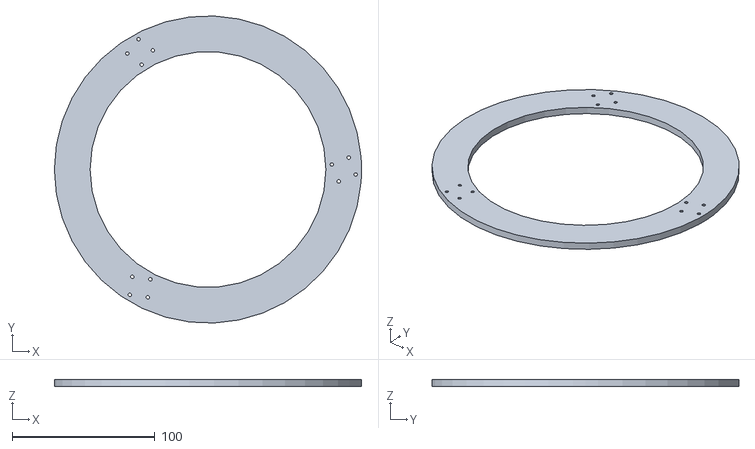
[picture p49: CAD file, 2016-02-10]
edisonLibmogiPackage/libmogi/simulation/resources/models/arm/launchpad.STL
215.0 x 214.8 x 5.00
