mogillc/nico/edisonLibmogiPackage/libmogi/simulation/resources/models/dmitri/leg/base.stl

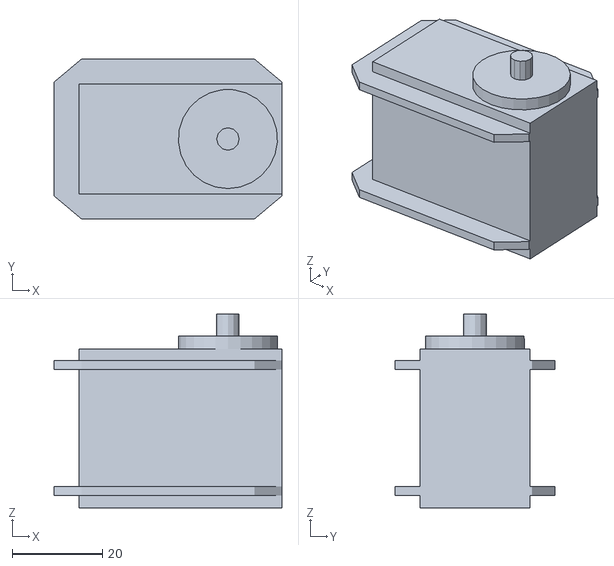
[picture p50: CAD file, 2016-02-10]
edisonLibmogiPackage/libmogi/simulation/resources/models/dmitri/leg/base.stl
50.6 x 35.4 x 43.0
