mogillc/nico/edisonLibmogiPackage/libmogi/simulation/resources/models/nico/leg/base.stl

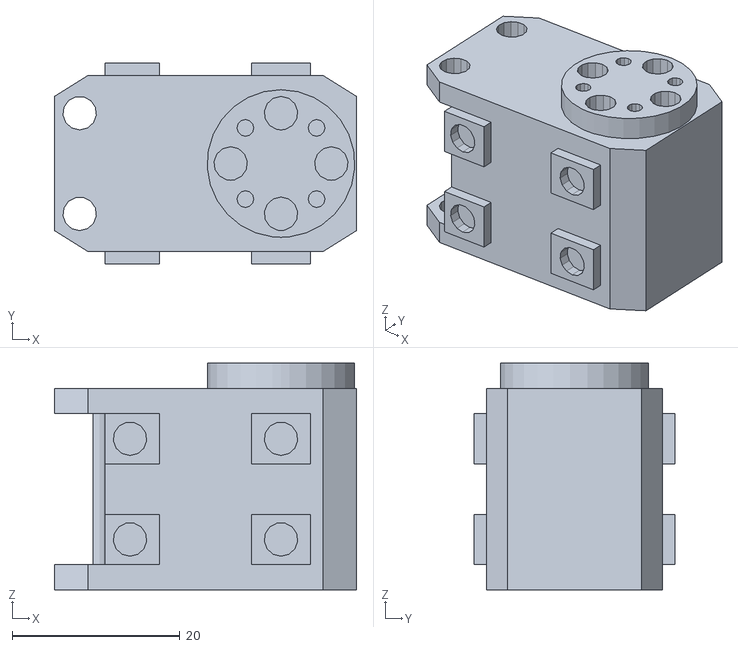
[picture p51: CAD file, 2016-02-10]
edisonLibmogiPackage/libmogi/simulation/resources/models/nico/leg/base.stl
36.0 x 24.0 x 27.0
