mogillc/nico/hardware/3D/body.STL

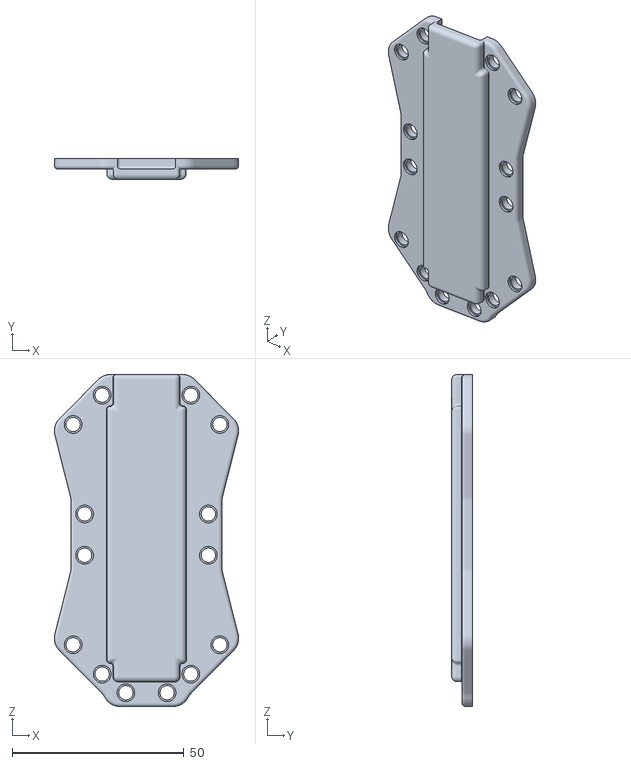
[picture p52: CAD file, 2016-10-25]
hardware/3D/body.STL
53.6 x 6.00 x 96.6
