mogillc/nico/edisonLibmogiPackage/examples/openGL/Objects/arm/segment2.STL

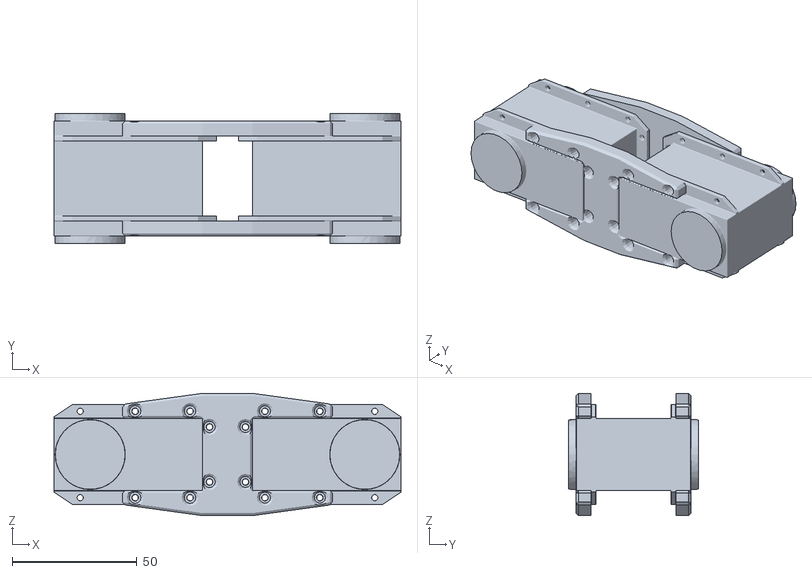
[picture p53: CAD file, 2016-02-10]
edisonLibmogiPackage/examples/openGL/Objects/arm/segment2.STL
139.0 x 52.0 x 49.0
