mogillc/nico/edisonLibmogiPackage/examples/openGL/Objects/cube.obj

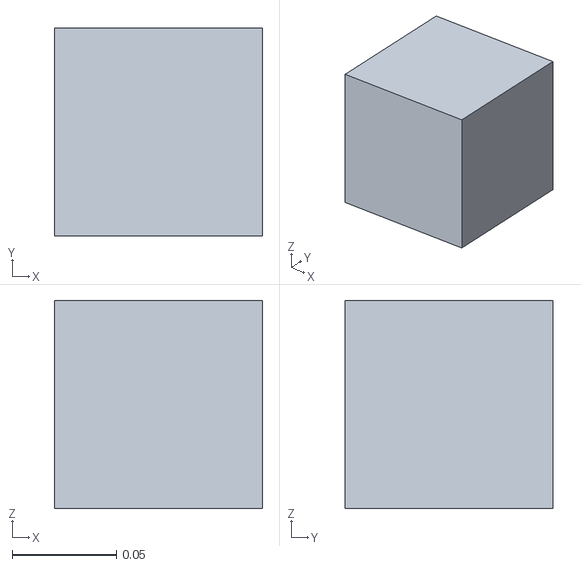
[picture p54: CAD file, 2016-02-10]
edisonLibmogiPackage/examples/openGL/Objects/cube.obj
0.1 x 0.1 x 0.1
