mogillc/nico/edisonLibmogiPackage/examples/openGL/STL/lightSource.STL

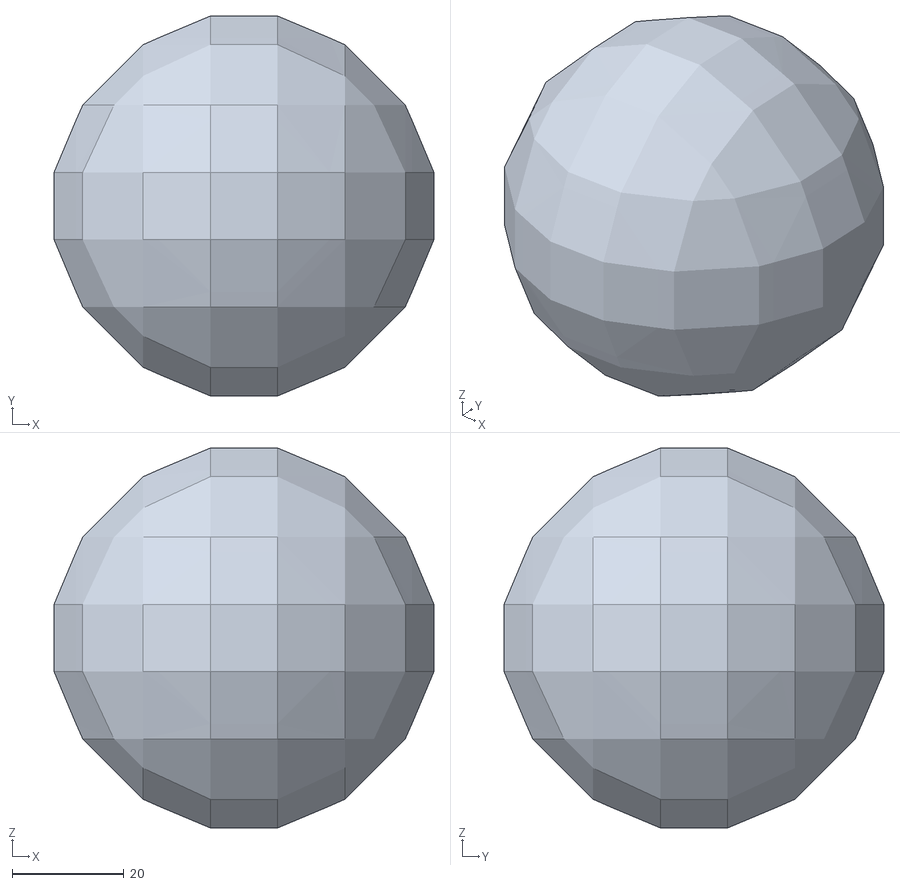
[picture p55: CAD file, 2016-02-10]
edisonLibmogiPackage/examples/openGL/STL/lightSource.STL
67.9 x 67.9 x 67.9
