mogillc/nico/edisonLibmogiPackage/libmogi/simulation/resources/models/dmitri/leg/tibia.stl

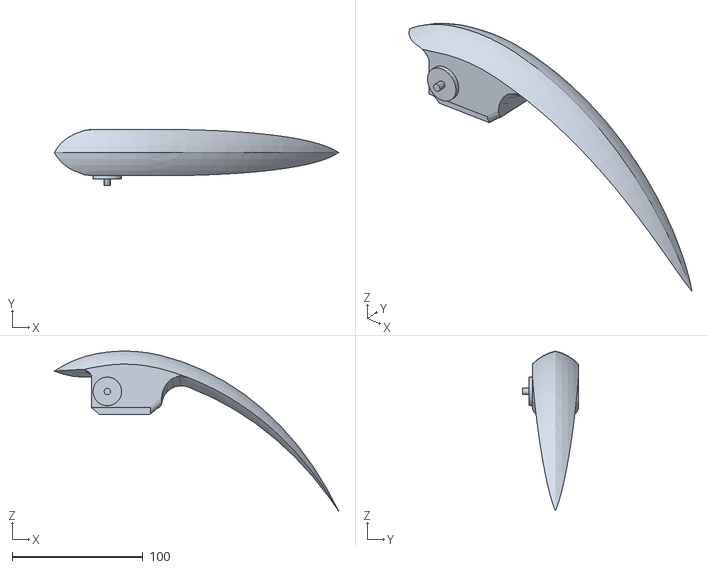
[picture p56: CAD file, 2016-02-10]
edisonLibmogiPackage/libmogi/simulation/resources/models/dmitri/leg/tibia.stl
217.5 x 43.1 x 122.5
