mogillc/nico/edisonLibmogiPackage/libmogi/simulation/resources/models/nico/leg/coxa.stl

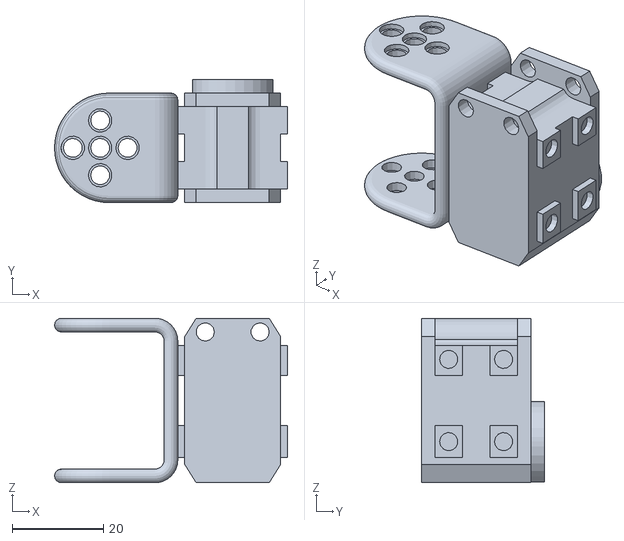
[picture p57: CAD file, 2016-02-10]
edisonLibmogiPackage/libmogi/simulation/resources/models/nico/leg/coxa.stl
51.0 x 27.0 x 36.0
