mogillc/nico/hardware/3D/femur_SLA.STL

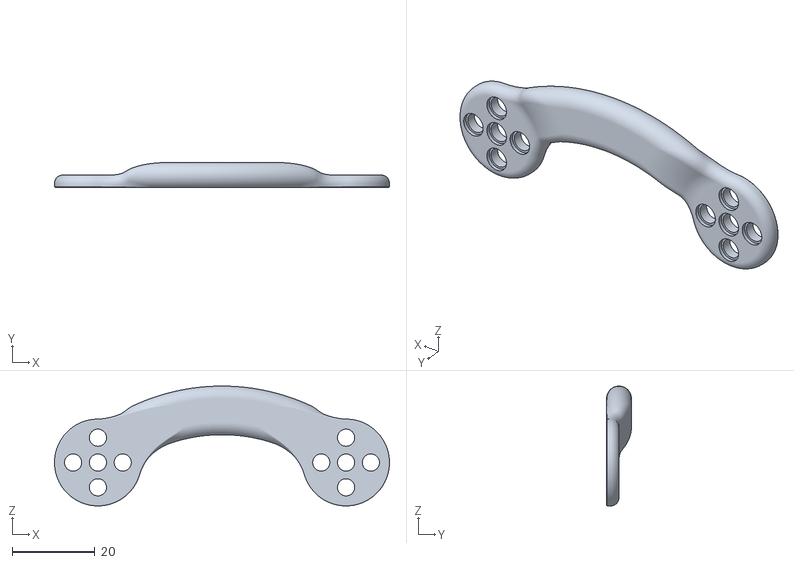
[picture p58: CAD file, 2016-10-25]
hardware/3D/femur_SLA.STL
81.0 x 6.00 x 29.0
