mogillc/nico/edisonLibmogiPackage/examples/openGL/Objects/arm/segment0.STL

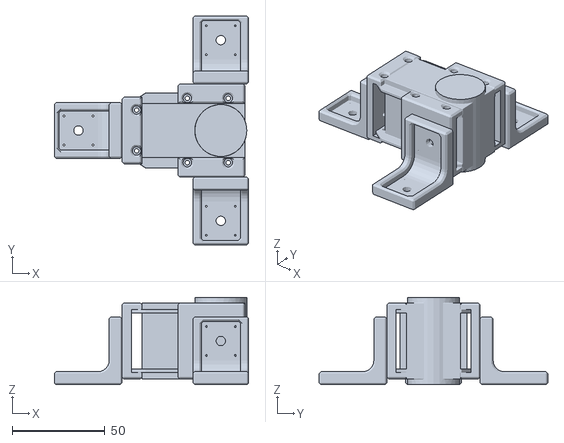
[picture p59: CAD file, 2016-02-10]
edisonLibmogiPackage/examples/openGL/Objects/arm/segment0.STL
104.6 x 123.2 x 47.0
