mogillc/nico/edisonLibmogiPackage/examples/openGL/STL/fit_pc2_opengl.STL

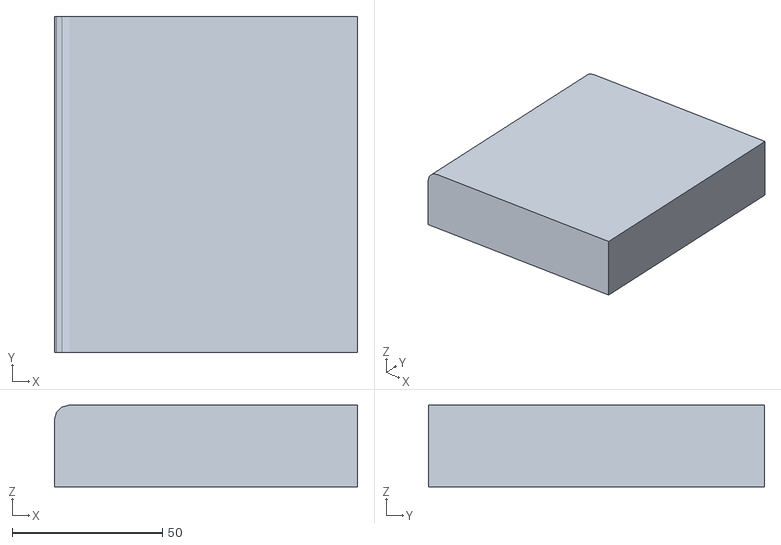
[picture p60: CAD file, 2016-02-10]
edisonLibmogiPackage/examples/openGL/STL/fit_pc2_opengl.STL
101.1 x 112.0 x 27.3
