mogillc/nico/edisonLibmogiPackage/libmogi/simulation/resources/models/arm/segment6.STL

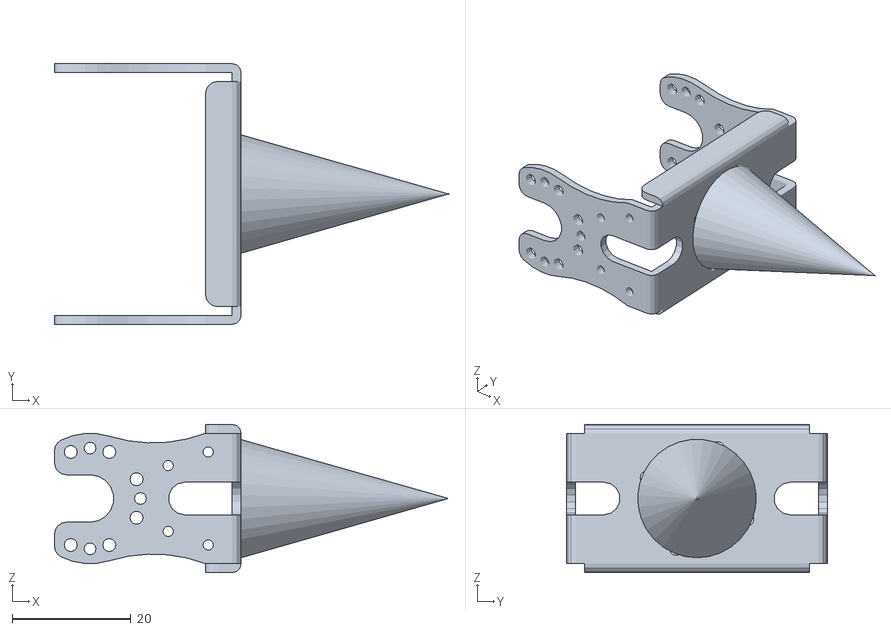
[picture p61: CAD file, 2016-02-10]
edisonLibmogiPackage/libmogi/simulation/resources/models/arm/segment6.STL
66.5 x 44.0 x 25.0
