mogillc/nico/edisonLibmogiPackage/libmogi/simulation/resources/models/dmitri/leg/femur.stl

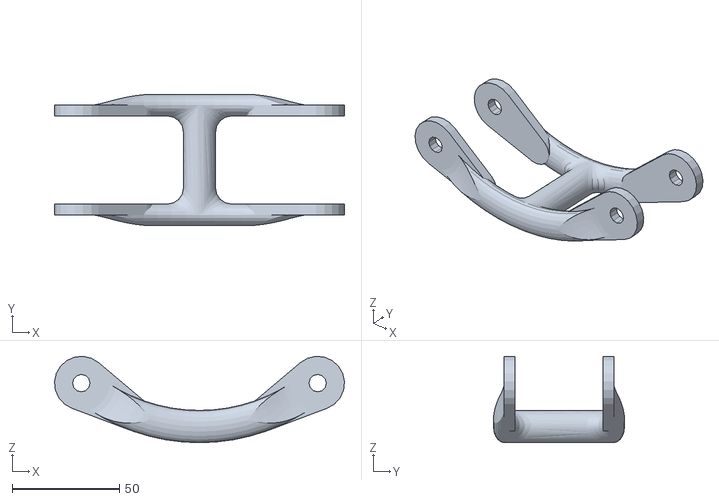
[picture p62: CAD file, 2016-02-10]
edisonLibmogiPackage/libmogi/simulation/resources/models/dmitri/leg/femur.stl
135.0 x 61.0 x 40.2
