mogillc/nico/edisonLibmogiPackage/libmogi/simulation/resources/models/nico/leg/femur.stl

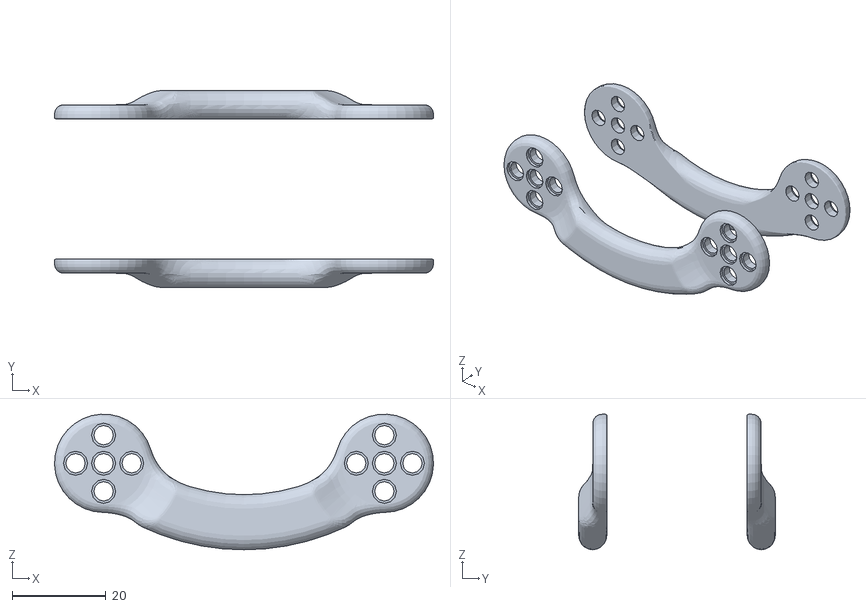
[picture p63: CAD file, 2016-02-10]
edisonLibmogiPackage/libmogi/simulation/resources/models/nico/leg/femur.stl
81.0 x 42.0 x 29.0
