mogillc/nico/hardware/3D/coxa_SLA.STL

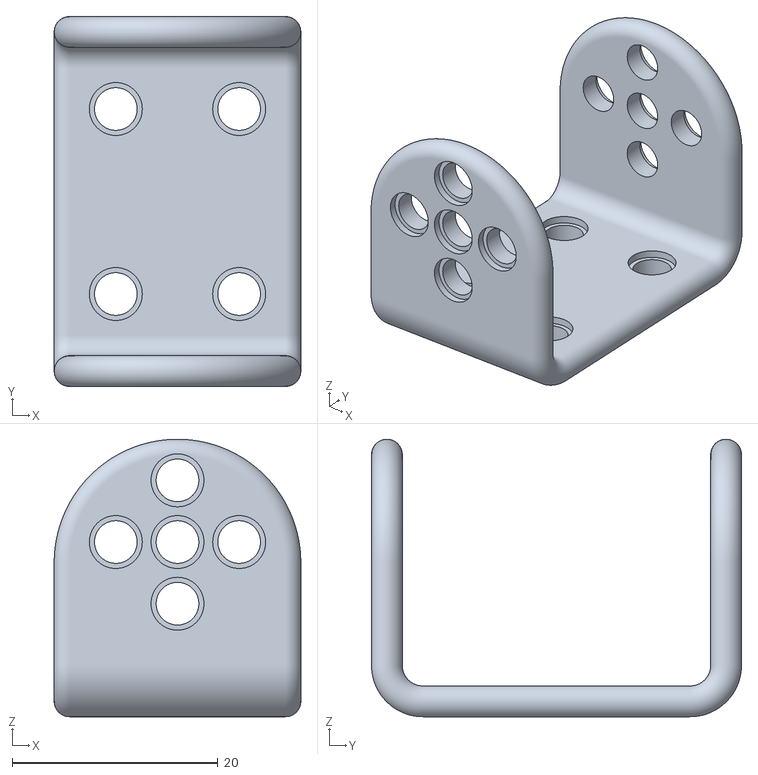
[picture p64: CAD file, 2016-10-25]
hardware/3D/coxa_SLA.STL
24.0 x 36.0 x 27.0
