mogillc/nico/edisonLibmogiPackage/examples/openGL/Objects/arm/segment3.STL

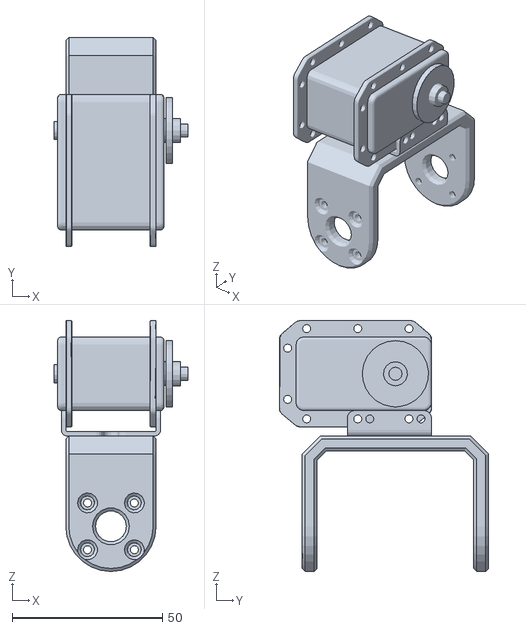
[picture p65: CAD file, 2016-02-10]
edisonLibmogiPackage/examples/openGL/Objects/arm/segment3.STL
44.5 x 69.6 x 83.4
