mogillc/nico/hardware/3D/SPO_5_SLA.STL

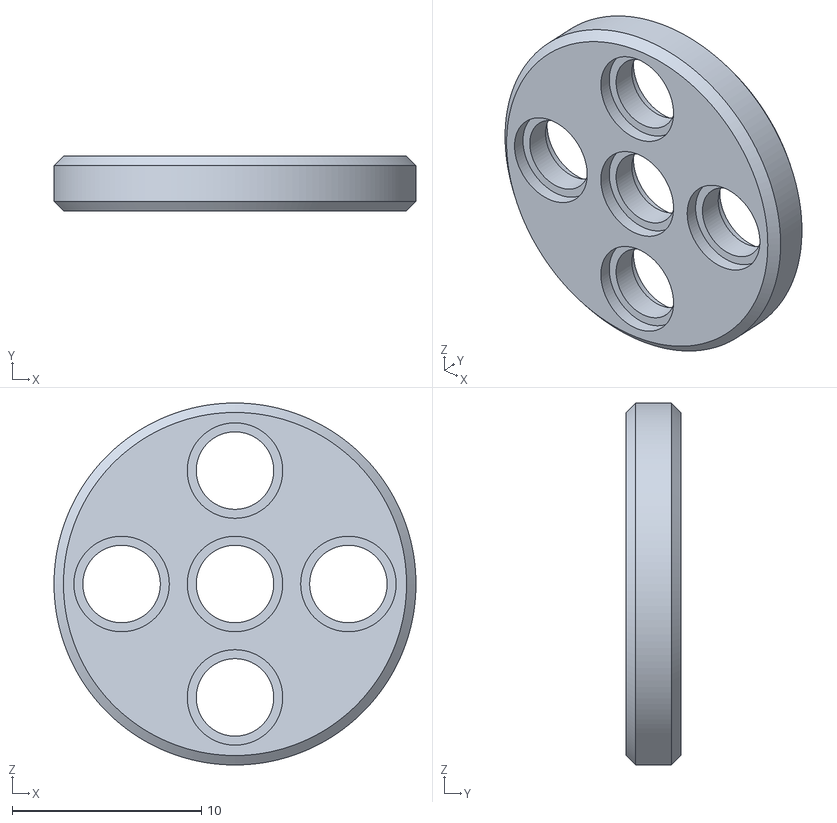
[picture p66: CAD file, 2016-10-25]
hardware/3D/SPO_5_SLA.STL
19.1 x 2.90 x 19.1
