mogillc/nico/edisonLibmogiPackage/examples/openGL/STL/camera_opengl.STL

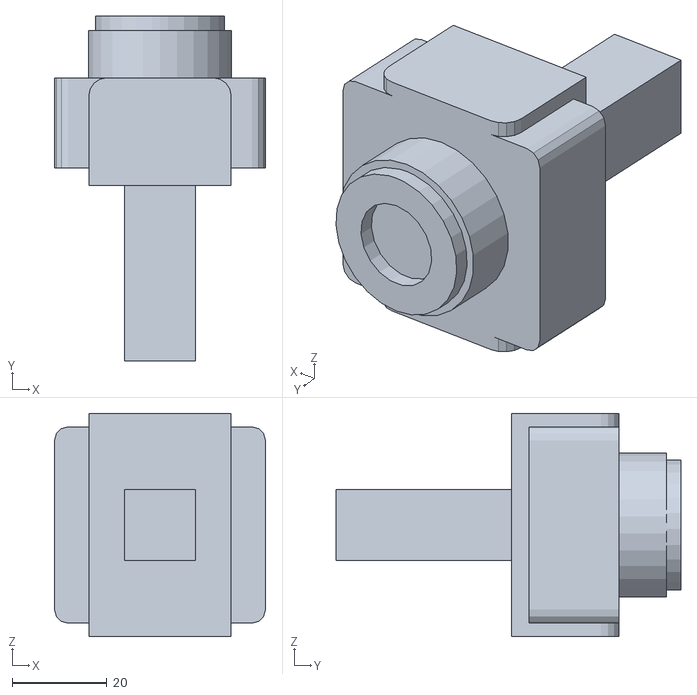
[picture p67: CAD file, 2016-02-10]
edisonLibmogiPackage/examples/openGL/STL/camera_opengl.STL
44.4 x 72.7 x 47.0
