mogillc/nico/edisonLibmogiPackage/examples/openGL/Objects/arm/segment1.STL

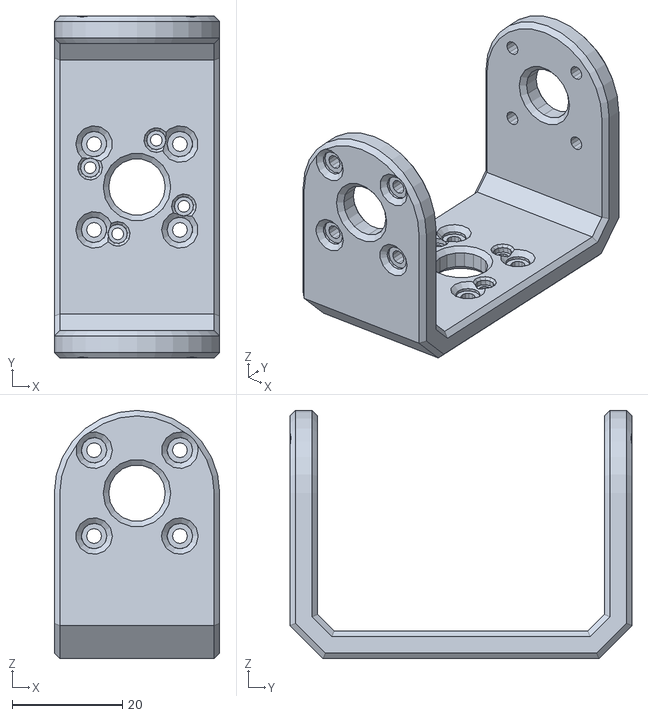
[picture p68: CAD file, 2016-02-10]
edisonLibmogiPackage/examples/openGL/Objects/arm/segment1.STL
30.0 x 62.0 x 45.0
