mogillc/nico/edisonLibmogiPackage/examples/openGL/STL/test.STL

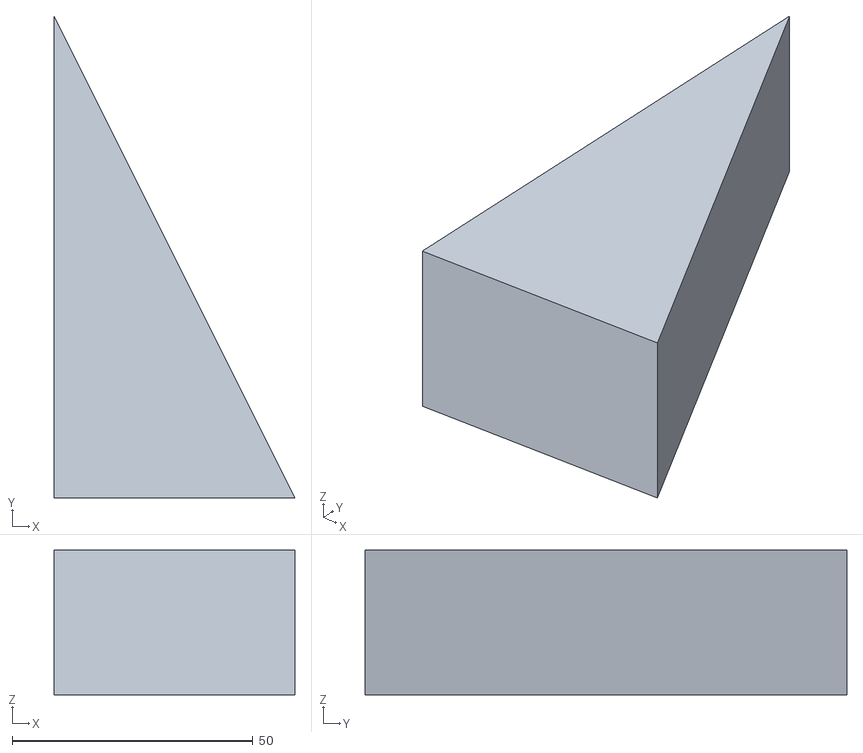
[picture p69: CAD file, 2016-02-10]
edisonLibmogiPackage/examples/openGL/STL/test.STL
50.0 x 100.0 x 30.0
