mogillc/nico/edisonLibmogiPackage/examples/openGL/STL/tilt camera bracket better opengl.STL

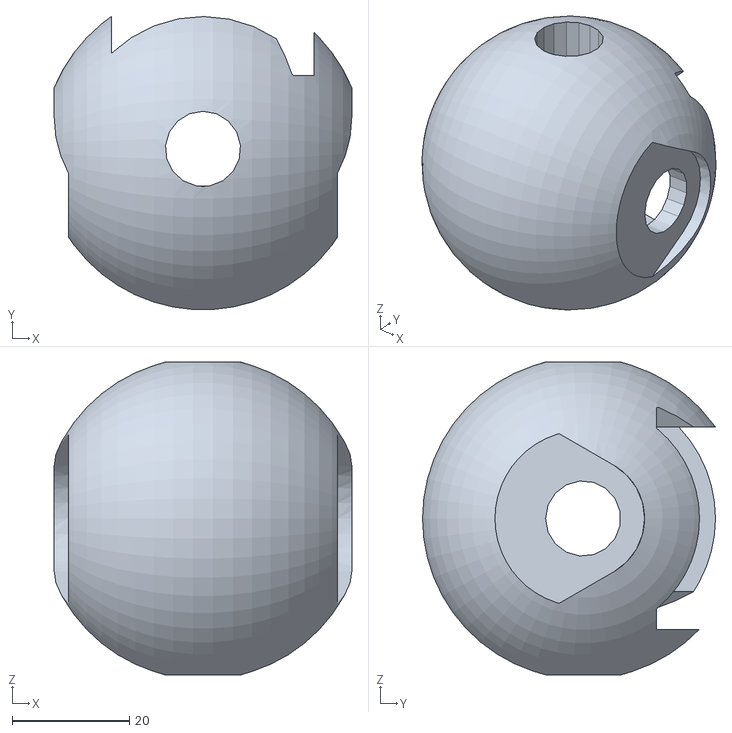
[picture p70: CAD file, 2016-02-10]
edisonLibmogiPackage/examples/openGL/STL/tilt camera bracket better opengl.STL
50.8 x 50.1 x 53.5
