mogillc/nico/edisonLibmogiPackage/examples/openGL/STL/Tibia_aluminum_opengl.STL

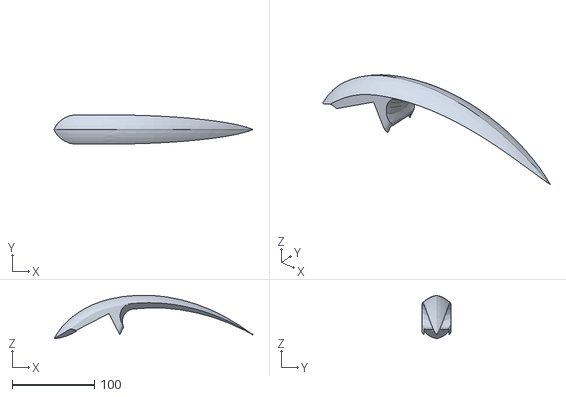
[picture p71: CAD file, 2016-02-10]
edisonLibmogiPackage/examples/openGL/STL/Tibia_aluminum_opengl.STL
242.4 x 35.5 x 53.0
