mogillc/nico/(list of files, cad)

Other CAD files:
edisonLibmogiPackage/examples/openGL/STL/rx28_rough_opengl.STL
