mogillc/nico/Assembly_Instructions.pdf

# Nico Instruction Manual

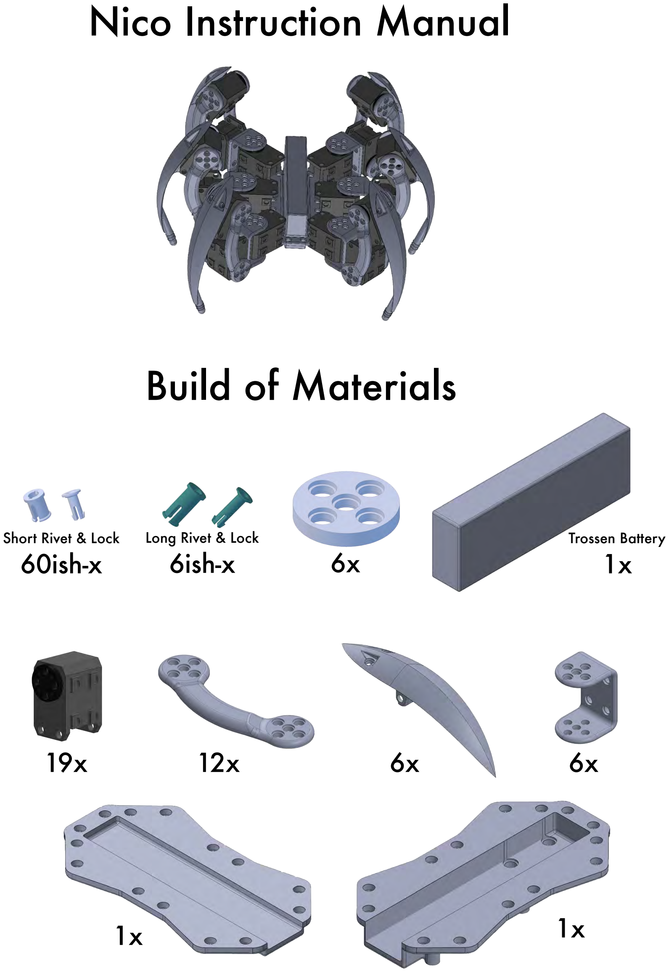
[picture p72: page 1]

# Build of Materials

19x | 12x | 6x | 6x
1x | 1x

Trossen Battery
1x

Long Rivet & Lock

# 6ish-x

Short Rivet & Lock
60ish-x | 6x

1 | 2 | 3

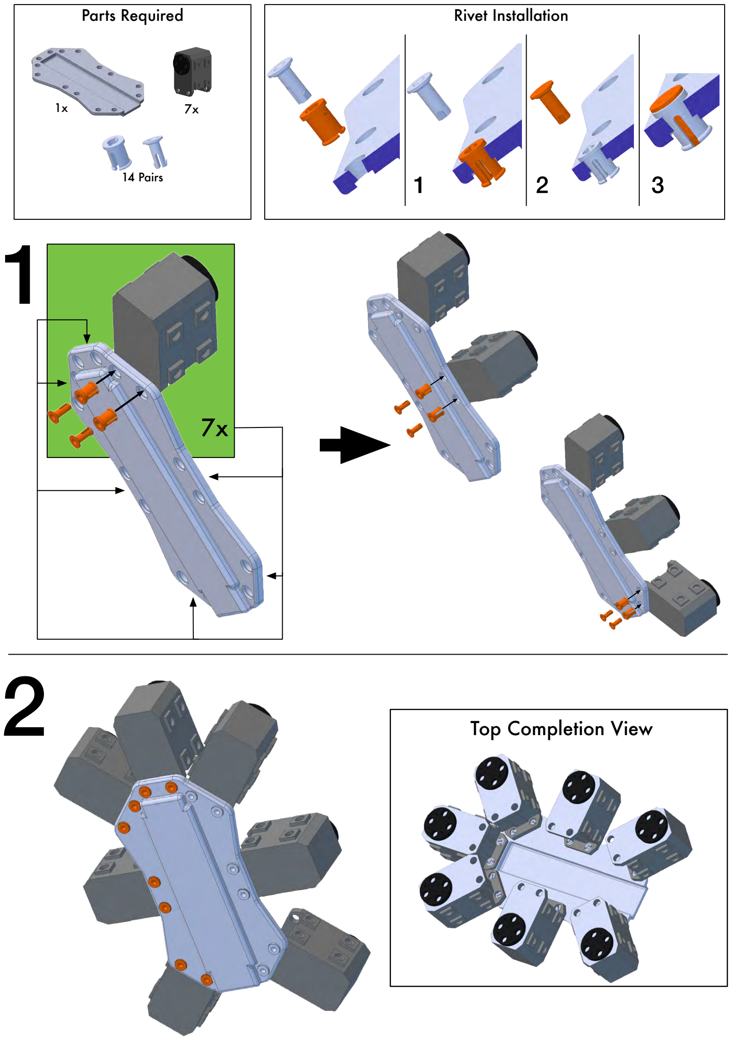
[picture p73: page 2]

1x | 7x

Parts Required

14 Pairs

Rivet Installation

### Top Completion View

1

7x

2

1 | 2 | 3

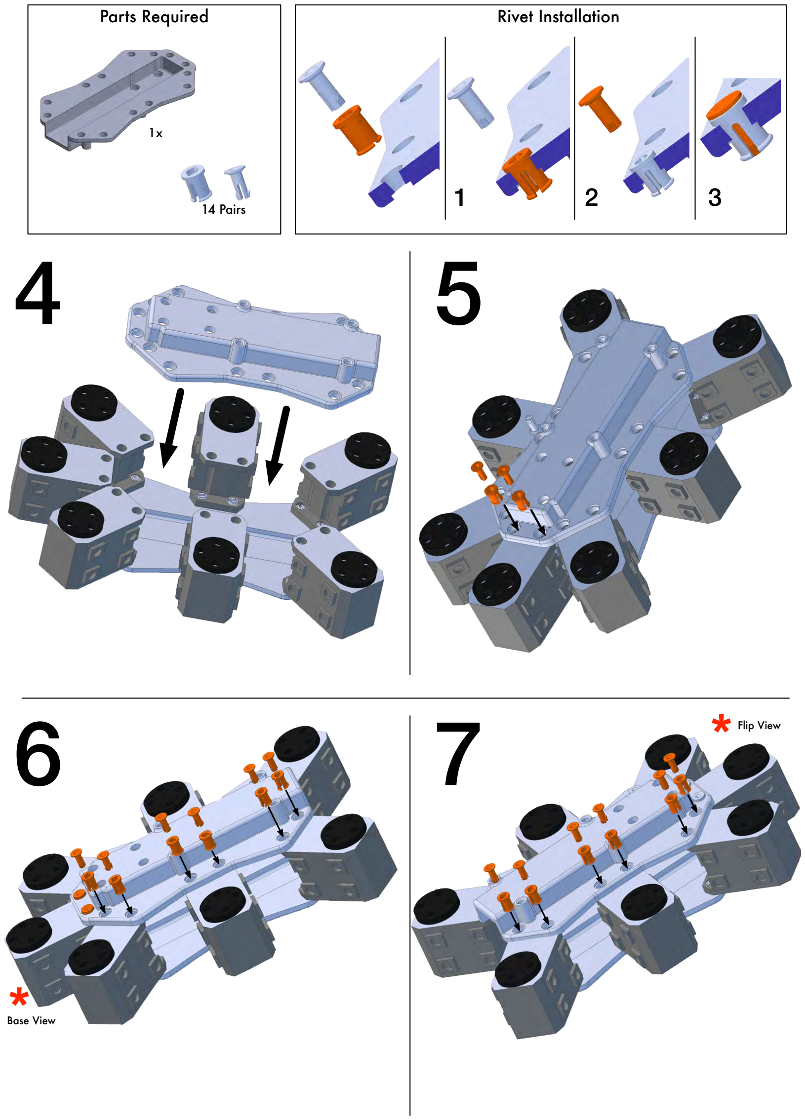
[picture p74: page 3]

1x

14 Pairs

Rivet Installation

4

6

5

7 *

*

Flip View

Base View

7

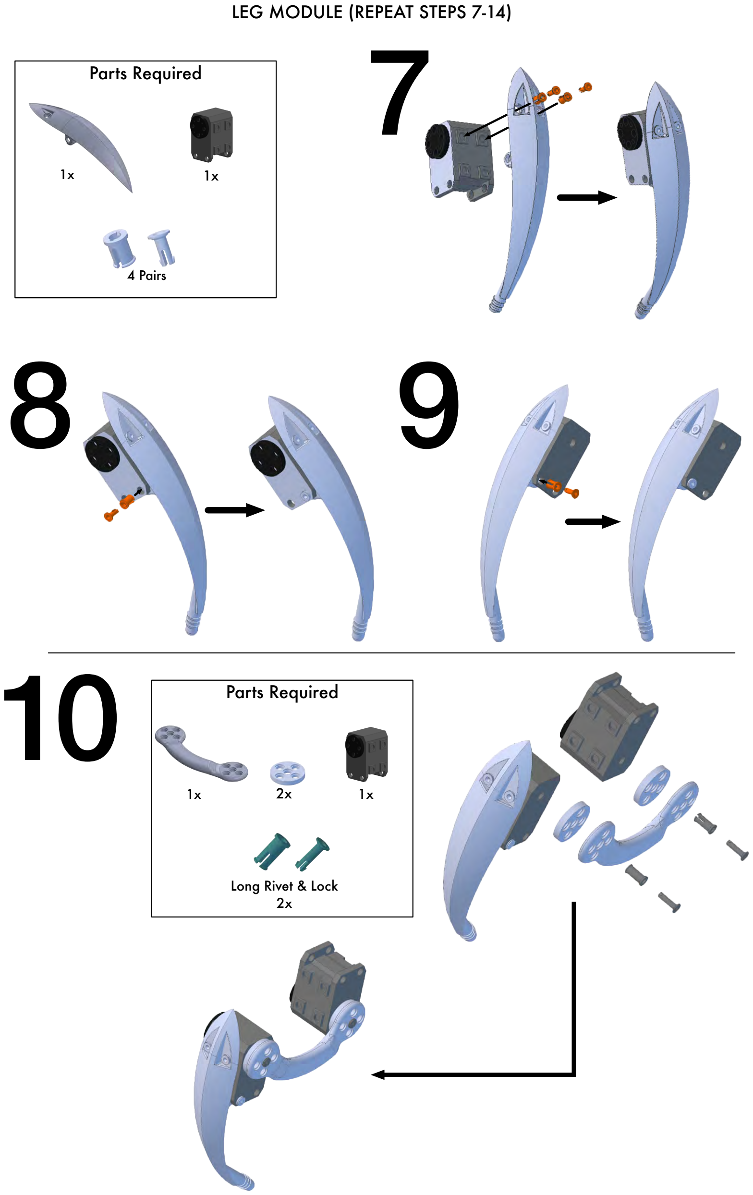
[picture p75: page 4]

8 | 9
1x | 1x

4 Pairs

10

1x | 1x

Parts Required

2x

Long Rivet & Lock
2x

LEG MODULE (REPEAT STEPS 7-14)

11a

11b

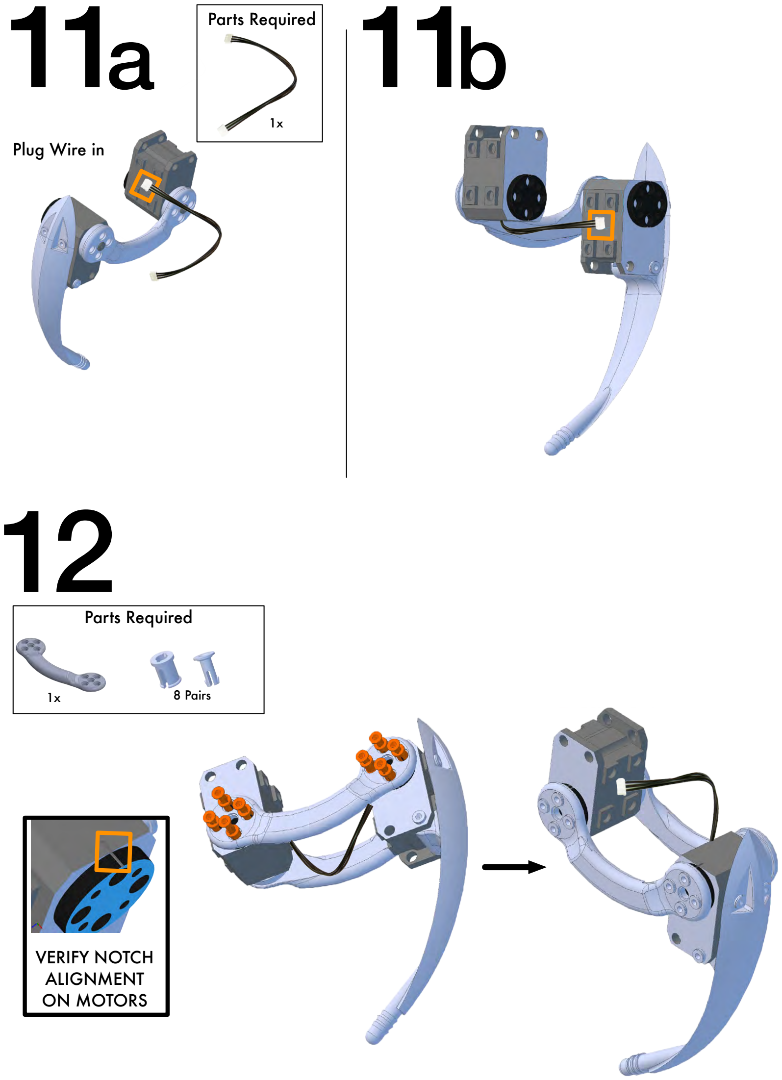
[picture p76: page 5]

1x
Plug Wire in

12

VERIFY NOTCH
ALIGNMENT
ON MOTORS

1x

Parts Required

8 Pairs

13

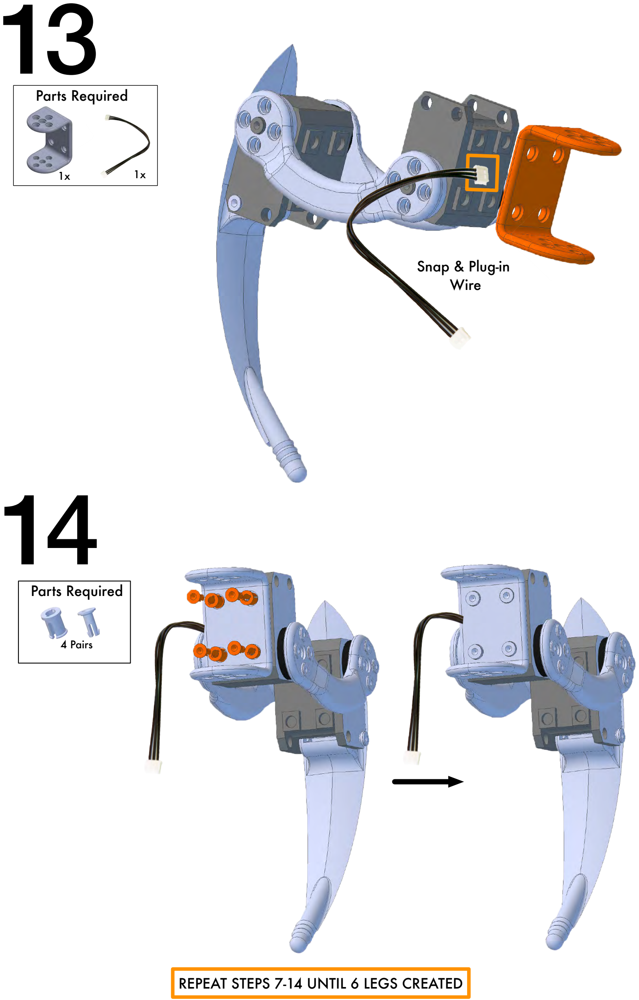
[picture p77: page 6]

14

Snap & Plug-in
Wire

1x

Parts Required

1x

Parts Required

4 Pairs

REPEAT STEPS 7-14 UNTIL 6 LEGS CREATED

15

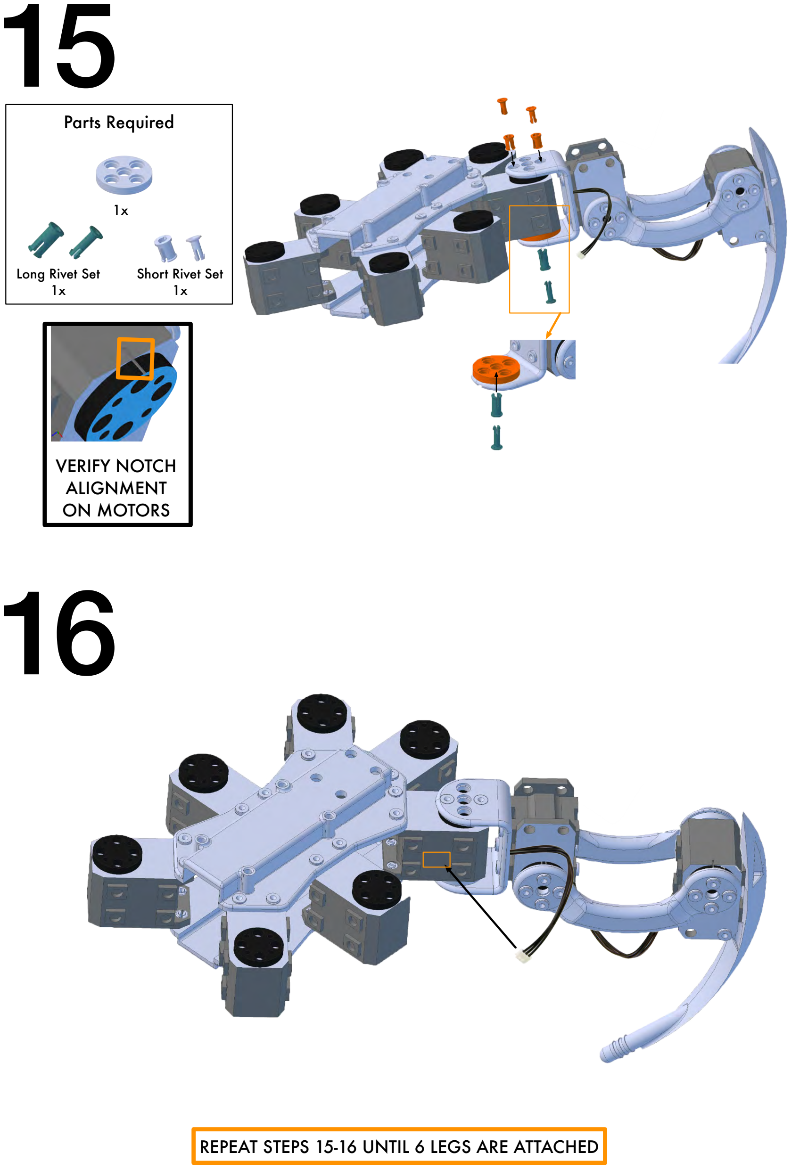
[picture p78: page 7]

Parts Required

16

1x

Long Rivet Set
1x

Short Rivet Set
1x

VERIFY NOTCH
ALIGNMENT
ON MOTORS

REPEAT STEPS 15-16 UNTIL 6 LEGS ARE ATTACHED

17

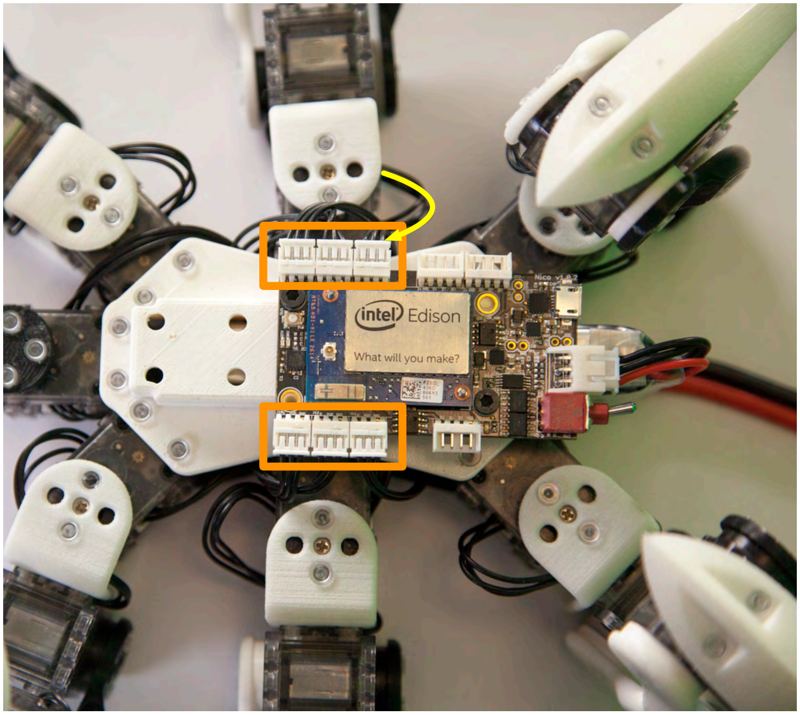
[picture p79: figure]

Each motor connects to the Printed Circuit Board (PCB). The orange boxes highlight the connector for all six motors. The yellow line is an example of the connector cable from motor to PCB.
