mogillc/nico/edisonLibmogiPackage/examples/openGL/shaderTesting/testTexture/diffuse.png

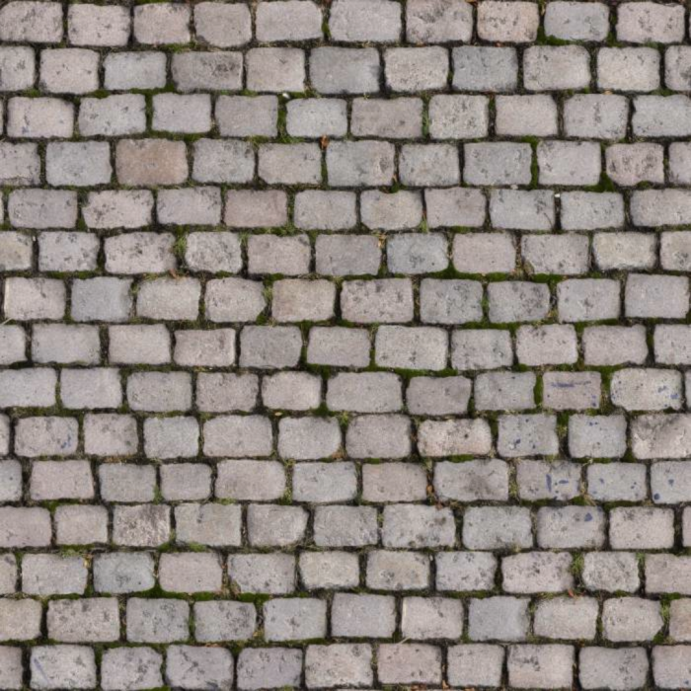
edisonLibmogiPackage/examples/openGL/shaderTesting/testTexture/diffuse.png
