mogillc/nico/edisonLibmogiPackage/examples/openGL/shaderTesting/testTexture/displacement.png

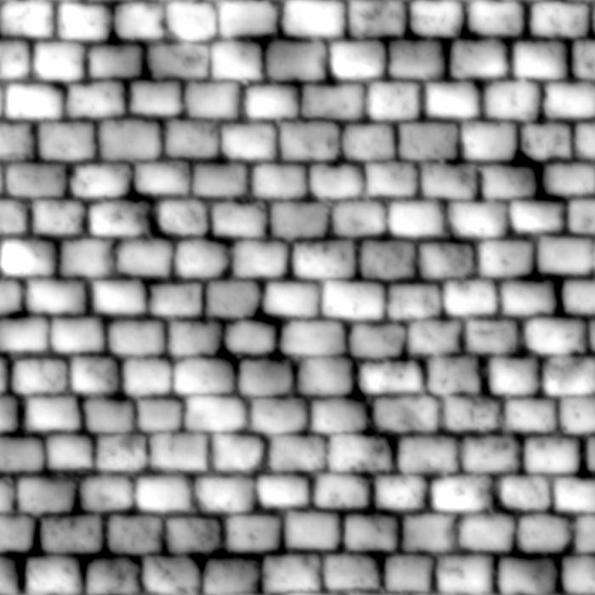
edisonLibmogiPackage/examples/openGL/shaderTesting/testTexture/displacement.png
