mogillc/nico/edisonLibmogiPackage/examples/openGL/shaderTesting/testTexture/normals.png

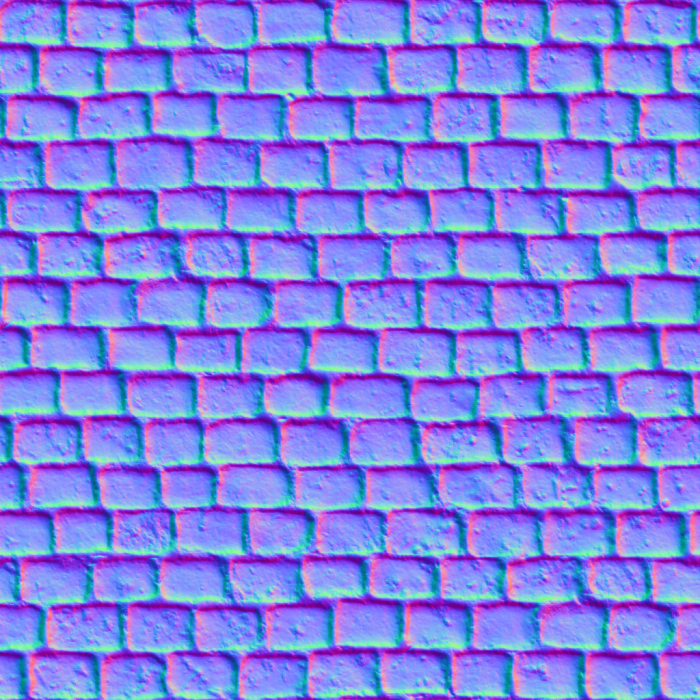
edisonLibmogiPackage/examples/openGL/shaderTesting/testTexture/normals.png
