mogillc/nico/edisonLibmogiPackage/examples/openGL/shaderTesting/testTexture/occlusion.png

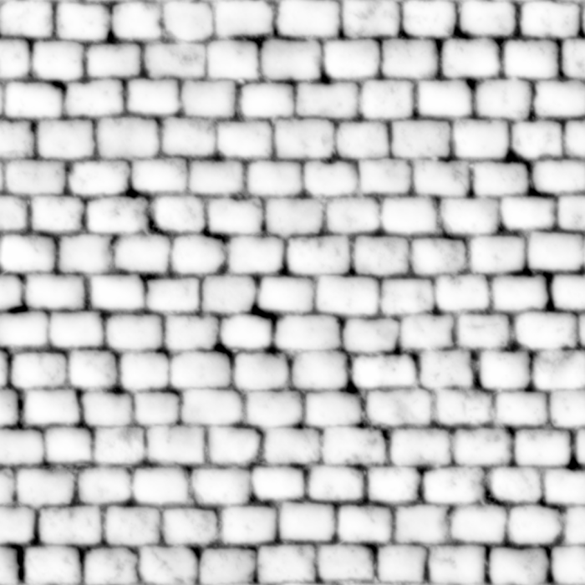
edisonLibmogiPackage/examples/openGL/shaderTesting/testTexture/occlusion.png
