mogillc/nico/(threads)

Thread 1 (2015-06-29):

MOLEX 53254 connector

joraff, 2015-06-29:
Hey, no issue - just wondering in what library you found your molex 53254 4pos device in? Or if you wouldn't mind sharing your library?

Thanks!

Thread 2 (2018-12-31):

Questions (No Issue)

NomadArchitect, 2018-12-31:
Hi,

I would like to know which Dynamixel servos are used for ? (to fit in the case)
Can i use another board for the Dynamixel servos or i should use the custom one ?
For the system, which one can i use ? Raspberry ? Intel Edison ?

Thanks for your response

Closed 2024-05-28.
