mogillc/nico/hardware/pcb/xbee/nico.brd

## EAGLE design hardware/pcb/xbee/nico.brd (2015-12-02)

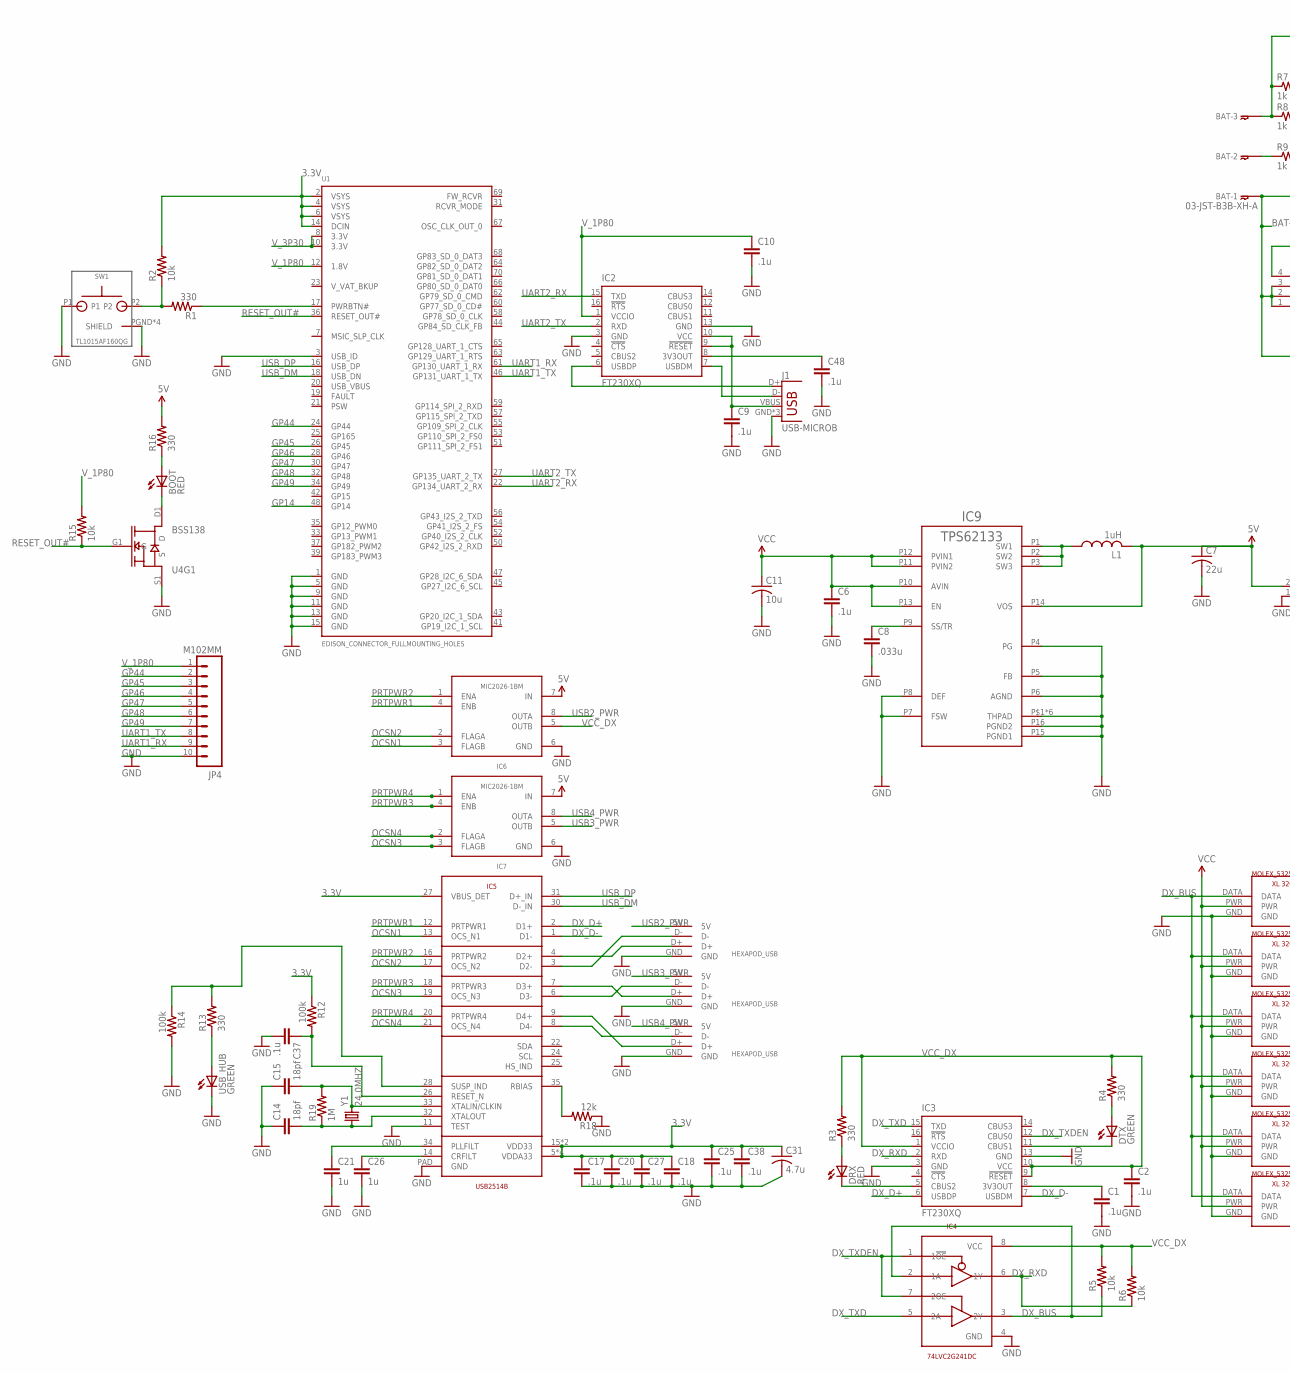
[picture p84: schematic nico.sch, part in row 1, column 1]

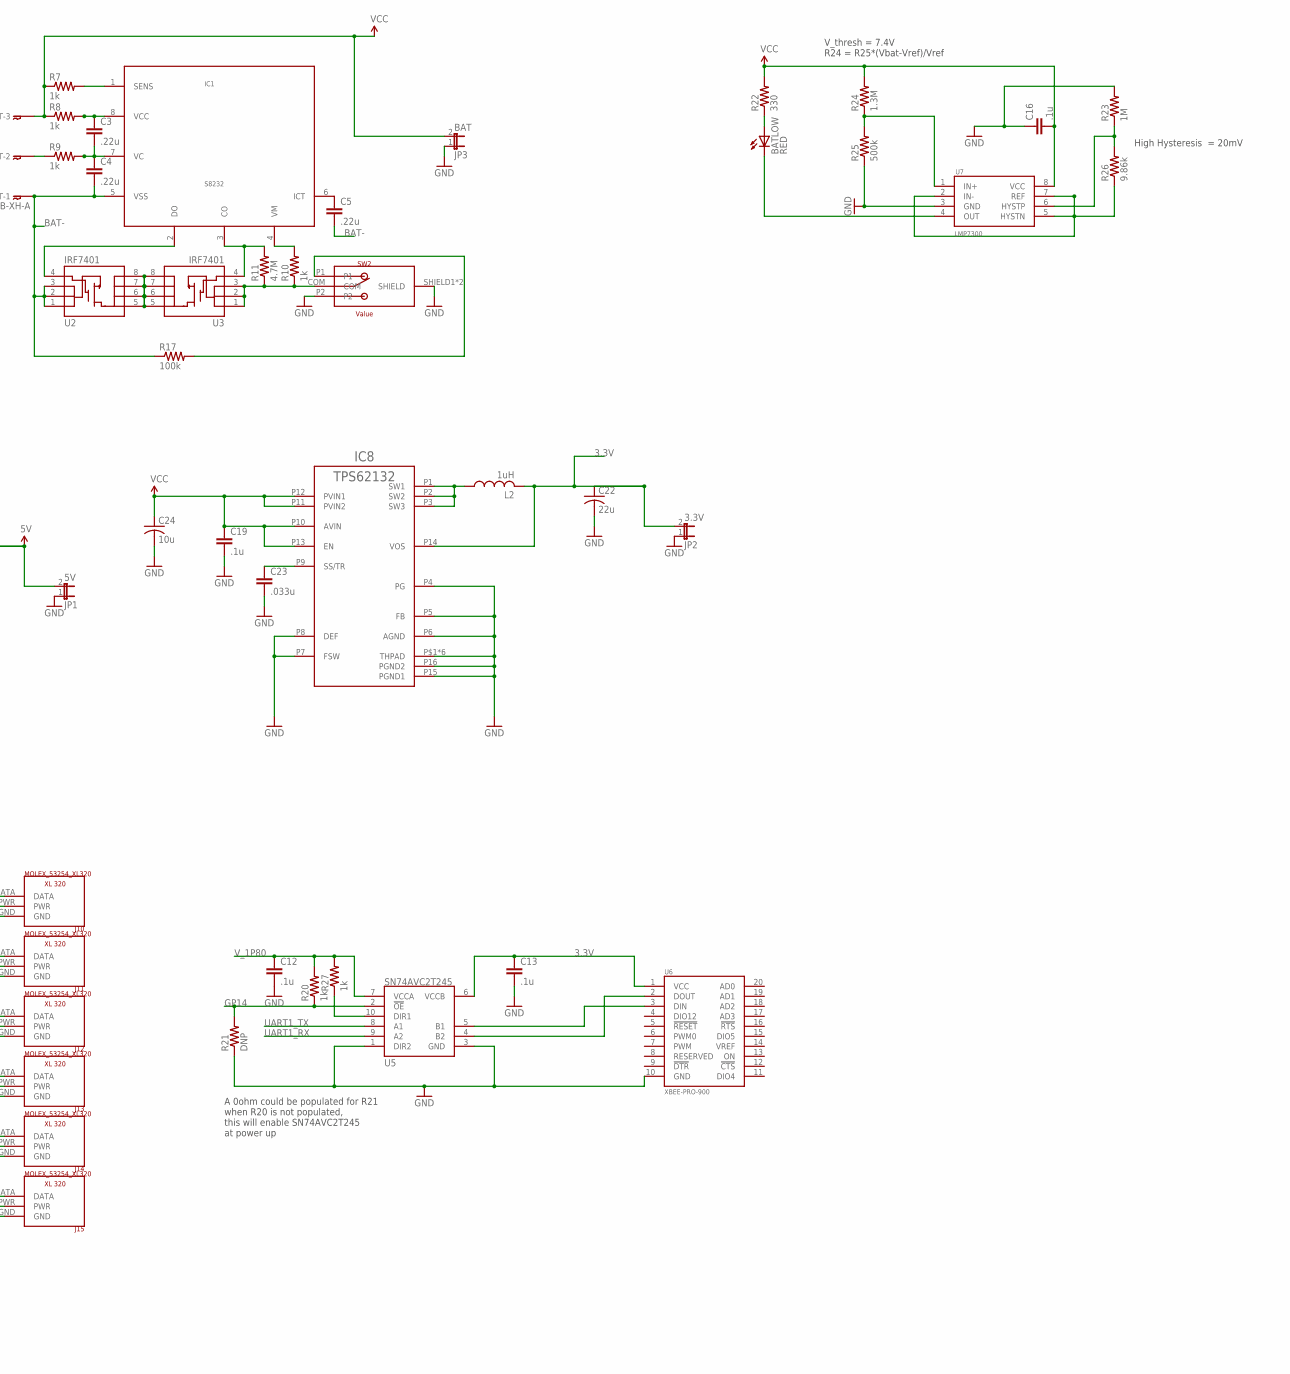
[picture p85: schematic nico.sch, part in row 1, column 2]

Parts:
BAT: 03-JST-B3B-XH-A; B3B-XH
BATLOW: RED; LED-0603
BOOT: RED; LED-0603
C1, C2, C6, C9, C10, C12, C13, C16, C17, C18, C19, C20, C25, C27, C37, C38, C48: .1u; C0402
C3, C4, C5: .22u; C0402
C7, C22: 22u; C0603
C8, C23: .033u; C0402
C11, C24: 10u; C0805
C14, C15: 18pf; C0402
C21, C26: 1u; C0402
C31: 4.7u; C0603
DRX: RED; LED-0603
DTX: GREEN; LED-0603
IC1: S8232; TSSOP8
IC2, IC3: FT230XQ; QFN16
IC4: 74LVC2G241DC; VSSOP
IC5: USB2514B; 36-QFN
IC6, IC7: MIC2026-1BM; 8-SOIC
IC8: TPS62132; VQFN-16
IC9: TPS62133; VQFN-16
J1: USB-MICROB
J2, J3, J4: HEXAPOD_USB; MOLEX_53254_4POS
J10, J11, J12, J13, J14, J15: MOLEX_53254_XL320; MOLES_53254_XL320
JP1: 5V; 1X02
JP2: 3.3V; 1X02
JP3: BAT; 1X02
JP4: M102MM; 1X10-2MM
L1, L2: 1uH; L2825P
R1, R3, R4, R13, R16, R22: 330; R0402
R2, R5, R6, R15: 10k; R0402
R7, R8, R9, R10, R20, R27: 1k; C0402
R11: 4.7M; C0402
R12, R14, R17: 100k; C0402
R18: 12k; C0402
R19, R23: 1M; C0402
R21: DNP; C0402
R24: 1.3M; C0402
R25: 500k; C0402
R26: 9.86k; C0402
SW1: TL1015AF160QG
SW2: TOGGLE_SWITCH_ET01MD1AGE
U1: EDISON_CONNECTOR_FULLMOUNTING_HOLES; EDISON_DAUGHTER
U2, U3: IRF7401; SO08
U4: BSS138; SOT363
U5: SN74AVC2T245; RSW-UQFN-10
U6: XBEE-PRO-900; XBEE-PRO-OEM
U7: LMP7300; 8-SOIC
USB_HUB: GREEN; LED-0603
Y1: 24.0MHZ; CRYSTAL-SMD-5X3

Connections:
3.3V: C13.1, C17.1, C18.1, C20.1, C22.1, C25.1, C27.1, C31.1, C38.1, IC5.5 (VDDA33), IC5.10 (VDDA33), IC5.15 (VDD33), IC5.23 (VDD33), IC5.27 (VBUS_DET), IC5.29 (VDDA33), IC5.36 (VDDA33), IC8.P14 (VOS), JP2.2, L2.2, R2.2, R12.1, U1.2 (VSYS), U1.4 (VSYS), U1.6 (VSYS), U1.14 (DCIN), U5.6 (VCCB), U6.1 (VCC)
5V: C7.1, IC6.7 (IN), IC7.7 (IN), IC9.P14 (VOS), JP1.2, L1.2, R16.2
BAT-: BAT.P$1, C4.2, C5.2, IC1.5 (VSS), R17.1, U2.1 (S), U2.2 (S), U2.3 (S)
DX_BUS: IC4.2 (1A), IC4.3 (2Y), J10.DATA, J11.DATA, J12.DATA, J13.DATA, J14.DATA, J15.DATA, R5.1
DX_D+: IC3.6 (USBDP), IC5.2 (D1+)
DX_D-: IC3.7 (USBDM), IC5.1 (D1-)
DX_RXD: IC3.2 (RXD), IC4.6 (1Y), R6.1
DX_TXD: IC3.15 (TXD), IC4.5 (2A)
DX_TXDEN: IC3.12 (CBUS0), IC4.1 (1!OE), IC4.7 (2OE)
GND: C1.2, C2.2, C6.2, C7.2, C8.2, C9.2, C10.2, C11.2, C12.2, C13.2, C14.1, C15.1, C16.1, C17.2, C18.2, C19.2, C20.2, C21.2, C22.2, C23.2, C24.2, C25.2, C26.2, C27.2, C31.2, C37.2, C38.2, C48.2, IC2.3 (GND), IC2.13 (GND), IC3.3 (GND), IC3.13 (GND), IC4.4 (GND), IC5.11 (TEST), IC5.PAD (GND), IC6.6 (GND), IC7.6 (GND), IC8.P4 (PG), IC8.P5 (FB), IC8.P6 (AGND), IC8.P7 (FSW), IC8.P8 (DEF), IC8.P15 (PGND1), IC8.P16 (PGND2), IC8.P$1 (THPAD), IC8.P$2 (THPAD), IC8.P$3 (THPAD), IC8.P$4 (THPAD), IC8.P$5 (THPAD), IC8.P$6 (THPAD), IC9.P4 (PG), IC9.P5 (FB), IC9.P6 (AGND), IC9.P7 (FSW), IC9.P8 (DEF), IC9.P15 (PGND1), IC9.P16 (PGND2), IC9.P$1 (THPAD), IC9.P$2 (THPAD), IC9.P$3 (THPAD), IC9.P$4 (THPAD), IC9.P$5 (THPAD), IC9.P$6 (THPAD), J1.GND, J1.MT1 (GND), J1.MT2 (GND), J2.GND, J3.GND, J4.GND, J10.GND, J11.GND, J12.GND, J13.GND, J14.GND, J15.GND, JP1.1, JP2.1, JP3.1, JP4.10, R14.2, R18.1, R21.1, R23.2, R25.1, SW1.P1, SW1.PGND (SHIELD), SW1.PGND2 (SHIELD), SW1.PGND3 (SHIELD), SW1.PGND4 (SHIELD), SW2.P2, SW2.SHIELD1 (SHIELD), SW2.SHIELD2 (SHIELD), U1.1 (GND), U1.3 (USB_ID), U1.5 (GND), U1.9 (GND), U1.11 (GND), U1.13 (GND), U1.15 (GND), U4.S1 (S), U5.1 (DIR2), U5.3 (GND), U6.10 (GND), U7.3 (GND), USB_HUB.C
GP14: R20.1, R21.2, U1.48 (GP14), U5.2 (!OE)
GP44: JP4.2, U1.24 (GP44)
GP45: JP4.3, U1.26 (GP45)
GP46: JP4.4, U1.28 (GP46)
GP47: JP4.5, U1.30 (GP47)
GP48: JP4.6, U1.32 (GP48)
GP49: JP4.7, U1.34 (GP49)
unnamed: R1.2, R2.1, SW1.P2
unnamed: DRX.C, IC3.5 (CBUS2)
unnamed: C1.1, IC3.8 (3V3OUT)
unnamed: IC2.6 (USBDP), J1.D+
unnamed: C15.2, IC5.33 (XTALIN/CLKIN), R19.2, Y1.3 (2)
unnamed: C14.2, IC5.32 (XTALOUT), R19.1, Y1.1
unnamed: IC5.7 (D3+), J3.D+
unnamed: C3.2, C4.1, IC1.7 (VC), R9.2
unnamed: C3.1, IC1.8 (VCC), R8.2
unnamed: R1.1, U1.17 (PWRBTN#)
unnamed: C8.1, IC9.P9 (SS/TR)
unnamed: R13.1, USB_HUB.A
unnamed: DTX.A, R4.1
unnamed: C21.1, IC5.34 (PLLFILT)
unnamed: C26.1, IC5.14 (CRFILT)
unnamed: DTX.C, IC3.11 (CBUS1)
unnamed: IC8.P1 (SW1), IC8.P2 (SW2), IC8.P3 (SW3), L2.1
unnamed: IC2.7 (USBDM), J1.D-
unnamed: C37.1, IC5.26 (RESET_N), R12.2
unnamed: C9.1, IC2.9 (!RESET), IC2.10 (VCC), J1.VBUS
unnamed: DRX.A, R3.1
unnamed: C23.1, IC8.P9 (SS/TR)
unnamed: IC5.9 (D4+), J4.D+
unnamed: IC5.28 (SUSP_IND), R13.2, R14.1
unnamed: C48.1, IC2.8 (3V3OUT)
unnamed: IC5.35 (RBIAS), R18.2
unnamed: IC5.8 (D4-), J4.D-
unnamed: C5.1, IC1.6 (ICT)
unnamed: IC1.1 (SENS), R7.2
unnamed: BAT.P$2, R9.1
unnamed: IC5.6 (D3-), J3.D-
unnamed: IC1.4 (VM), R10.2
unnamed: R10.1, R11.1, SW2.COM, U3.1 (S), U3.2 (S), U3.3 (S)
unnamed: BOOT.C, U4.D1 (D)
unnamed: U2.5 (D), U2.6 (D), U2.7 (D), U2.8 (D), U3.5 (D), U3.6 (D), U3.7 (D), U3.8 (D)
unnamed: BOOT.A, R16.1
unnamed: IC1.2 (DO), U2.4 (G)
unnamed: IC1.3 (CO), R11.2, U3.4 (G)
unnamed: IC5.3 (D2-), J2.D-
unnamed: IC5.4 (D2+), J2.D+
unnamed: IC9.P1 (SW1), IC9.P2 (SW2), IC9.P3 (SW3), L1.1
unnamed: R17.2, SW2.P1
unnamed: BATLOW.C, U7.4 (OUT)
unnamed: BATLOW.A, R22.1
unnamed: R26.1, U7.2 (IN-), U7.5 (HYSTN), U7.7 (REF)
unnamed: R23.1, R26.2, U7.6 (HYSTP)
unnamed: R24.1, R25.2, U7.1 (IN+)
unnamed: R27.1, U5.10 (DIR1)
unnamed: U5.5 (B1), U6.3 (DIN)
unnamed: U5.4 (B2), U6.2 (DOUT)
OCSN1: IC5.13 (OCS_N1), IC6.3 (FLAGB)
OCSN2: IC5.17 (OCS_N2), IC6.2 (FLAGA)
OCSN3: IC5.19 (OCS_N3), IC7.3 (FLAGB)
OCSN4: IC5.21 (OCS_N4), IC7.2 (FLAGA)
PRTPWR1: IC5.12 (PRTPWR1), IC6.4 (ENB)
PRTPWR2: IC5.16 (PRTPWR2), IC6.1 (ENA)
PRTPWR3: IC5.18 (PRTPWR3), IC7.4 (ENB)
PRTPWR4: IC5.20 (PRTPWR4), IC7.1 (ENA)
RESET_OUT#: R15.1, U1.36 (RESET_OUT#), U4.G1 (G)
UART1_RX: JP4.9, U1.61 (GP130_UART_1_RX), U5.9 (A2)
UART1_TX: JP4.8, U1.46 (GP131_UART_1_TX), U5.8 (A1)
UART2_RX: IC2.15 (TXD), U1.22 (GP134_UART_2_RX)
UART2_TX: IC2.2 (RXD), U1.27 (GP135_UART_2_TX)
USB2_PWR: IC6.8 (OUTA), J2.5V
USB3_PWR: IC7.5 (OUTB), J3.5V
USB4_PWR: IC7.8 (OUTA), J4.5V
USB_DM: IC5.30 (D-_IN), U1.18 (USB_DN)
USB_DP: IC5.31 (D+_IN), U1.16 (USB_DP)
VCC: BAT.P$3, C6.1, C11.1, C16.2, C19.1, C24.1, IC8.P10 (AVIN), IC8.P11 (PVIN2), IC8.P12 (PVIN1), IC8.P13 (EN), IC9.P10 (AVIN), IC9.P11 (PVIN2), IC9.P12 (PVIN1), IC9.P13 (EN), J10.PWR, J11.PWR, J12.PWR, J13.PWR, J14.PWR, J15.PWR, JP3.2, R7.1, R8.1, R22.2, R24.2, U7.8 (VCC)
VCC_DX: C2.1, IC3.1 (VCCIO), IC3.9 (!RESET), IC3.10 (VCC), IC4.8 (VCC), IC6.5 (OUTB), R3.2, R4.2, R5.2, R6.2
V_1P80: C10.1, C12.1, IC2.1 (VCCIO), JP4.1, R15.2, R20.2, R27.2, U1.12 (1.8V), U5.7 (VCCA)
V_3P30: U1.8 (3.3V), U1.10 (3.3V)

Notes on the sheet:
A 0ohm could be populated for R21 when R20 is not populated, this will enable SN74AVC2T245 at power up
V_thresh = 7.4V R24 = R25*(Vbat-Vref)/Vref
High Hysteresis = 20mV

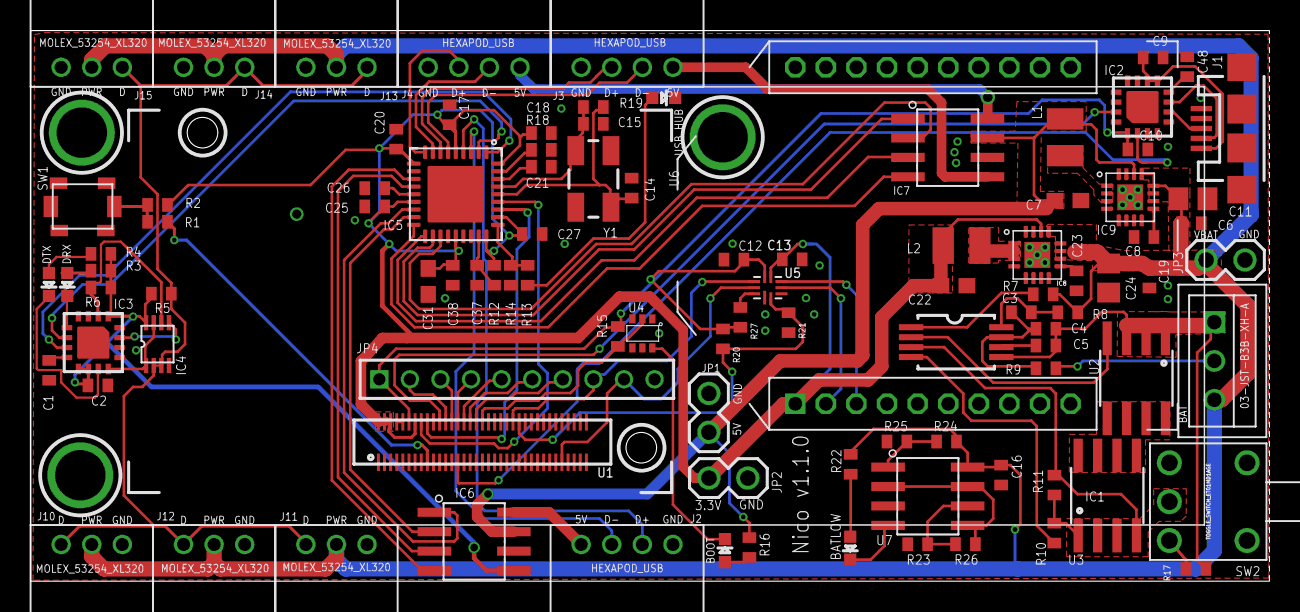
[picture p86: board nico.brd from above]

Board: 2 copper layers, 81.0 x 36.0 mm, 99 parts (0 on the bottom side), 89 nets.
