mogillc/nico/(commit log)

2015-06-25 first commit with PCB design
    [BOM.xlsx, nico.brd, nico.sch]
2015-12-02 added xbee version
    [BOM.xlsx, nico.brd, nico.sch]
2016-02-10 Adding libmogi sources and examples.
    [Femur_rx28_opengl.STL, Tibia_aluminum_opengl.STL, base.stl, body.stl, body_opengl.STL, brickWall.obj, camera_opengl.STL, capsule.obj]
2016-03-11 Fixed json vlaue creation bug. Also added improvements to mogisim
    [testCube.ply]
2016-10-25 Added STL files and instructions
    [SPO_5_SLA.STL, body.STL, coxa_SLA.STL, femur_SLA.STL, tibiaLong_SLA.STL]
2021-04-19 copied line caused compile error
    [Interface.cpp]
2021-04-20 Fisxed threads linker issue
